kisan2970/ems-haptic-feedback/INTRODUCTION.md

# Introduction: 근육을 액추에이터로 쓰는 햅틱

> 가상 물체에 부딪히면 손목이 저절로 튕기고, 가상 물체를 들면 팔이 아래로 끌린다.
> 모터도 외골격도 없이, 사용자 자신의 근육을 전기로 수축시켜 만든 힘 피드백이다.

이 문서는 저장소를 처음 보는 사람을 위한 입구다. 무엇을 왜 만드는지, 지금 어디까지 왔는지, 어디부터 읽으면 되는지를 담았다.

---

## 1. 문제

VR과 게임은 눈과 귀는 속이지만 **몸은 속이지 못한다.** 가상 벽을 치면 손이 그대로 통과하고, 가상 덤벨은 아무 무게가 없다.

힘을 되돌려 주는 기존 방법은 무겁다.

| 방법 | 한계 |
|---|---|
| 진동 모터 (컨트롤러, 햅틱 조끼) | "윙" 하는 촉감뿐, 팔을 실제로 밀지 못한다 |
| 외골격, 로봇 팔 | 힘은 크지만 모터·배터리 때문에 크고 비싸다 |
| 물리 소품 (passive haptics) | 장면마다 실물을 준비해야 한다 |

## 2. 아이디어

**힘을 내는 모터는 이미 몸 안에 있다.** 근육이다.

피부에 붙인 전극으로 약한 전기 펄스를 보내면(EMS, Electrical Muscle Stimulation) 근육이 의지와 상관없이 수축한다. 이 수축을 가상 세계의 사건에 맞춰 켜고 끄면, 패드 몇 장과 손바닥만 한 회로로 힘 피드백이 생긴다. Pedro Lopes 연구팀의 *Impacto*(UIST 2015)와 *Providing Haptics to Walls & Heavy Objects in VR*(CHI 2017)이 보여준 방향이다.

## 3. 이 프로젝트가 만드는 것

| 시연 | 사용자가 하는 일 | 몸에 일어나는 일 |
|---|---|---|
| **총 반동** | 화면 속 방아쇠를 당긴다 | 손목 신전근이 120ms 수축해 손목이 위로 튕긴다 |
| **벽 충돌** | 손을 뻗어 가상 벽에 닿는다 | 부딪힌 속도에 비례한 길이(60~220ms)로 반동이 온다 |
| **물체 무게** | 가상 물체를 들고 있는다 | 손목 신전근(무거우면 삼두근도)이 계속 수축해 팔이 아래로 끌린다 |
| **공 2개 블라인드 비교** | 똑같은 공 2개를 번갈아 든다 | 한쪽만 자극이 켜진다. 어느 쪽이 무거운지 맞힌 비율을 기록한다 |

무게감의 원리는 단순하다. 손바닥을 위로 하고 팔꿈치를 90도로 들면, 중력은 손등 쪽으로 손을 꺾고 팔꿈치를 펴는 방향으로 당긴다. 같은 방향으로 당기는 근육을 자극하면 사용자는 반대쪽 근육으로 더 버텨야 하고, 그 노력을 **무게**로 느낀다.

## 4. 어떻게 동작하나

```
IMU(손등) ─▶ Arduino Uno ─▶ PC (Processing: 충돌 판정, 자극 길이 계산)
                 ▲                         │
                 └──────── 명령 ◀──────────┘
                 │
                 ▼  빛으로만 연결 (PhotoMOS, 전기적 절연)
 상용 저주파 자극기(TENS 7000, 9V) ─▶ 전극 ─▶ 근육
```

핵심 원칙 세 가지.

1. **자극기는 만들지 않는다.** 전류 크기와 파형은 인증받은 상용 기기가 맡고, 이 시스템은 "언제 흐르게 할지"만 정한다. 기기 내부는 개조하지 않는다.
2. **PC와 몸 사이에 전기 경로가 없다.** 자극기는 배터리로 떠 있고, 제어 신호는 PhotoMOS의 빛으로만 건너간다.
3. **안전장치는 겹겹이, 서로 독립적으로.**

| 계층 | 무엇이 고장 나도 막는가 |
|---|---|
| 기기: 노브 물리 스토퍼, 배터리 구동 | 우리 회로 전체 |
| 참가자 STOP 버튼 (전극 선에 직렬) | 아두이노와 PC |
| 555 하드웨어 감시 (신호가 끊기면 0.05초 안에 차단) | 펌웨어 멈춤 |
| 펌웨어 한도 (반동 250ms, 무게 5초, 1분 누적 30초, 하트비트) | PC 프로그램 |
| 절차 (스크리닝, 동의, 전극은 팔에만) | 사람의 판단 |

## 5. 지금 어디까지 왔나 (2026-11)

- [x] 회로·안전 구조·프로토콜 설계
- [x] TENS 기기 단독으로 근수축 확인 (300µs, 40Hz)
- [x] 브레드보드 조립, 자동 점검 12/12, PhotoMOS 켬 22Ω / 끔 OL
- [x] 펌웨어 v2.1: 안전 한도 버그 수정 / v2.2: 강도 사다리 4단계. PC 시뮬레이션 12/12 (우노·ESP32)
- [x] LED 부하로 TENS 게이팅 동작 확인 (11/9)
- [x] Processing 시연 4종, 공 비교 결과 CSV 기록
- [ ] v2.2 보드 업로드 후 재점검, 강도 사다리 조립·LED 확인
- [ ] 하드웨어 차단 시험, TENS로 팔 무게감 시험
- [ ] 벤치 검사(저항 부하, 안전장치 11종), 본인 캘리브레이션, 발표

남은 핵심 질문은 하나다. **이 자세에서 무게감이 실제로 느껴지는가.** 결과에 따라 다음 단계가 갈린다([SUMMARY.md](SUMMARY.md) 9.2).

## 6. 이 프로젝트의 기여

- **안전을 먼저 설계한 저비용 EMS 햅틱 구조.** 상용 TENS + 광 절연 게이팅 + 하드웨어 감시 + 펌웨어 예산. 부품비 수만 원대로 재현할 수 있다.
- **충돌 물리량을 자극으로 바꾸는 매핑.** 충돌 속도 → 자극 길이, 근육 지연(40~80ms)을 메우는 50ms 예측 트리거.
- **무게감을 블라인드로 검증하는 절차.** 화면 지연을 켜고 끈 두 조건으로 EMS 자체의 효과를 따로 잰다.
- **재현 가능한 기록.** 배선도, 구멍 단위 브레드보드 배치도, 단계별 통과 기준, 하드웨어 없이 돌리는 펌웨어 시뮬레이터.

## 7. 앞으로

| 단계 | 내용 |
|---|---|
| 이번 과목 | 손목 신전근 + 삼두근, 반동과 무게감 시연 |
| 다음 | 이두근·삼각근 추가, 한 팔 슬리브, ESP32 무선 + Unity VR |
| 장기 | 상체 웨어러블. IMU 여러 개로 관절 각도를 재며 근육을 제어하는 폐루프 "몸을 움직이는 옷" |

## 8. 어디부터 읽을까

| 알고 싶은 것 | 문서 |
|---|---|
| 한 장으로 요약 | 이 문서 |
| 왜 이렇게 결정했나 | [BRIEF.md](BRIEF.md) |
| 지금까지 한 일, 검증 기록, 다음 할 일 | [SUMMARY.md](SUMMARY.md) |
| 회로, 프로토콜, 알고리즘 상세 | [README.md](README.md) |
| 직접 따라 만들기 (단계별 통과 기준) | [GUIDE.md](GUIDE.md) |
| 관련 논문 | [references.md](references.md) |

## 안전 고지

전기 근육 자극은 심장박동기·이식 전자기기 사용자, 뇌전증, 심장질환, 임신 중인 사람에게 금기다. 전극은 팔에만 붙인다(가슴·목·머리, 양팔에 걸친 배치 금지). 이 저장소는 교육용 연구 프로토타입 기록이며, 사람에게 연결하기 전에 [GUIDE.md](GUIDE.md)의 벤치 검사를 모두 통과해야 한다.
