kisan2970/ems-haptic-feedback/SUMMARY.md

# 프로젝트 진행 요약 (2026-09-08 ~ 2026-10-28, 10/28 검토 반영)

EMS 근자극 기반 가상 충돌 반동 및 무게감 피드백 시스템. 지금까지 정한 것, 만든 것, 확인한 것, 남은 것을 한 문서에 모았다.

- 설계 상세: [README.md](README.md)
- 단계별 절차: [GUIDE.md](GUIDE.md)
- 외부 공유용 브리핑: [BRIEF.md](BRIEF.md)
- 논문: [references.md](references.md)
- GitHub: https://github.com/kisan2970/ems-haptic-feedback

---

## 1. 목표

**과목**: 대학 인터랙티브 시스템 프로토타이핑 발표·데모.

**시연 두 가지**
1. **총 반동**: 방아쇠를 당기면 손목이 순간적으로 들린다. CH1 손목 신전근을 120ms 자극.
2. **물체 무게**: 똑같이 생긴 공 2개 중 하나를 들면 더 무겁게 느껴진다. 무거운 공을 드는 동안만 손목 신전근(나중에 삼두근 추가)을 계속 자극하고, 화면 속 손도 느리게 따라오게 한다. 블라인드 테스트로 정답률을 기록해 결과 슬라이드에 쓴다.

**사용자 우선순위**: 반동보다 무게감.

**장기 방향**: VR(Unity) 연동, 상체 전반 웨어러블. 이번 과목 범위는 아님.

---

## 2. 핵심 결정과 근거

### 2.1 자극원: 상용 TENS 기기, 출력단 무개조
- 자극 파형과 전류 제한은 인증받은 상용 기기에 맡기고, 우리 회로는 "언제 흐르게 할지"만 정한다. 잘못 동작했을 때의 위험 증명 책임이 기기 쪽에 남는다.
- 직접 만든 자극기는 펌웨어 버그 하나로 직류가 흘러 화상이 날 수 있고, 다른 사람에게 적용할 근거가 약하다. 8채널 이상 웨어러블 단계에서나 검토.
- Lopes 연구실의 openEMSstim도 같은 철학이다.

### 2.2 기기 선택: TENS 7000 계열 (아날로그 노브, 9V)
- "TENS라서 근수축이 안 된다"는 주장(외부 AI의 첫 판단)을 파라미터로 검토해 틀렸다고 결론. 이후 그 AI도 판단을 수정했다.

| 파라미터 | 근수축에 필요 | 산 기기 | 판정 |
|---|---|---|---|
| 펄스 폭 | 200~300µs | **300µs** (실측 확인) | 충분 |
| 주파수 | 30~50Hz | 2~150Hz | 충분 |
| 전류 | 전완 15~30mA | 최대 100mA @500Ω | 충분 |
| 파형 | 양극성 | 비대칭 양극성 구형파 | 동급 |
| 연속 출력 | 필요 | Normal + 타이머 C | 있음 |
| 강도 상한 고정 | 물리 스토퍼 | 아날로그 노브 | 가능 |

- 산 것: 알리 동형품(박스 표기 R-C1011), 배터리 듀얼 채널 버전. 4채널 충전식은 버튼형·프로그램 강제·패드 감지 때문에 제외.
- 약점: 정전류가 아니어서 건조한 피부에서 전류가 줄어든다. 피부 준비와 패드 크기로 보완.

### 2.3 제어 방식: 출력선 게이팅
- 기기는 고정 강도로 켜 두고, 전극으로 가는 선 한 가닥에 **PhotoMOS(AQY210EH)**를 넣어 1ms 단위로 개폐한다.
- 일반 포토커플러(PC817)는 35V 단방향이라 양극성 고전압 펄스를 못 통과시켜 제외.
- 버튼을 대신 눌러 주는 방식은 램프업 때문에 짧은 반동이 불가능해 제외.
- 실측: PhotoMOS가 켜졌을 때 22Ω. 피부 저항 500~2,000Ω 대비 손실 1~4%.

### 2.4 이 보드로 할 수 있는 것과 없는 것
- 가능: 켜고 끄는 시점, 지속 시간(반동 10~250ms, 무게 최대 5초), 채널 선택.
- 세기(강약): 기본은 TENS 노브가 정한다. 펌웨어의 듀티 값은 출력을 끊어 떨림을 만들 뿐 약해지지 않는다.
- **11/9 강도 사다리 추가 (v2.2)**: 출력 경로에 470Ω·1kΩ을 직렬로 넣고 PhotoMOS 2개로 각각 건너뛰어 4단계(`$L,ch,0~3`). 노브 세기보다 세질 수 없고, 리셋되면 가장 약한 단계가 된다. 상세는 README 1.4b.

### 2.5 무게감 원리
- 손바닥을 위로 하고 팔꿈치를 90도로 한 자세에서, 중력은 손을 손등 쪽으로 꺾고 팔꿈치를 펴는 방향으로 당긴다.
- 손목 신전근(손을 손등 쪽으로 젖힘)과 삼두근(팔꿈치를 폄)은 **중력과 같은 방향**으로 당긴다. 사용자는 반대쪽 근육으로 더 버티게 되고, 그 노력을 무게로 느낀다. Lopes 외 CHI 2017과 같은 원리.
- **자세가 틀리면 무게감이 아니다.** 손바닥을 아래로 해서 움켜쥐면 오히려 손이 들린다.
- 예상 크기: 손목만 1.5~3kg 상당, 삼두근을 더하면 더 큼. 2~3초 지나면 근피로로 약해짐.
- 손바닥 압력은 EMS로 못 만들므로 진짜 공을 쥐게 한다. 화면 속 손 지연이 "당김"을 "무게"로 해석하게 돕는다.

### 2.6 떨림 줄이기
- 75Hz에서 마사지기 같은 떨림이 느껴졌다. 완전히 없앨 수는 없다(피부 감각신경이 먼저 반응).
- **40Hz, 300µs, 강도는 운동 역치(M)보다 약간 위**로 설정. Normal 모드 외(Burst, Modulation 등)는 쓰지 않는다.
- 실제 시연은 짧게 켜져서 떨림이 덜 느껴진다.

### 2.7 MCU: 아두이노 우노
- ESP32도 있으나, 이번 과목은 5V 회로 여유와 안정성 때문에 **우노**로 확정. 포트는 COM11(CH340). COM3~6은 블루투스 포트.
- ESP32 펌웨어는 VR 단계용으로 유지.

---

## 3. 안전 구조

| 계층 | 수단 | 무엇이 고장 나도 동작하나 |
|---|---|---|
| 기기 | 출력단 무개조, 노브 물리 스토퍼, 9V 배터리 플로팅 | 우리 회로 전체 |
| 하드웨어 차단 | 참가자 STOP(NC) 전극 경로 직렬, PhotoMOS 무전원 시 열림, 게이트 핀 10k 풀다운 | 아두이노, PC |
| 하드웨어 감시 | 555 "펄스 끊김 감지": 아두이노가 D9를 계속 토글할 때만 켜짐. 멈추면 약 0.05초 안에 차단 | 펌웨어 멈춤, 핀 고착 |
| 펌웨어 | 반동 최대 250ms·간격 300ms, 무게 최대 5초+휴식 2초, 1분 예산, 하트비트 1초, 워치독 250ms, 비상정지 인터럽트 | PC 프로그램 |
| 절차 | 스크리닝(심박조율기, 뇌전증, 심장질환, 임신, 피부 상처), 동의, 전극은 팔에만, 본인 선시연 | 사람 판단 |

**간소화판(현재 조립본)**: 키스위치·부저·실험자 비상정지를 뺐다. 대신 실험자는 노트북 SPACE 키(전부 정지)를 맡고, 참가자 STOP과 하드웨어 감시는 그대로.

**절연 원칙**: TENS 쪽 선(주황)은 아두이노 GND·핀에 절대 닿지 않는다. 브레드보드 20·21열(CH2는 50·51열) 위쪽 a~e는 TENS 전용.

---

## 4. 회로 (CH1 기준, 우노)

| 블록 | 연결 |
|---|---|
| TLC555 (DIP-8) | 8·4번 → 5V, 1번 → GND, 5번 → 10nF → GND |
| 타이밍 | 6·7번 연결 → **470kΩ** → 5V, 같은 점 → **100nF(104)** → GND (약 0.05초) |
| 트리거 | D4 → 10nF → 555 2번, 2번 → 10kΩ → 5V |
| 유지 신호 (Q3) | D9 → 100nF → 1kΩ → Q3 베이스, 베이스 → 10kΩ → GND, 컬렉터 → 555 6·7번 |
| 출력 | 555 3번 → 330Ω → PhotoMOS 1번 |
| 게이트 (Q1) | D5 → 1kΩ → Q1 베이스, D5 → 10kΩ → GND, 컬렉터 → PhotoMOS 2번 |
| PhotoMOS (DIP-4) | 1번 LED+, 2번 LED−, **3·4번 출력** |
| TENS 쪽 | TENS 리드 A → PhotoMOS 3번(a21), 4번(a20) → 참가자 STOP 11번 → 12번 → 패드 A. 리드 B → 패드 B |
| 패널 (간소화판) | D3 → GND 직결(상시 아밍 허용), D2·D8 비움 |
| IMU | 3.3V → VCC, GND, A4 → SDA, A5 → SCL |

CH2: 트리거 D7, 게이트 D6, 유지 신호 D10, 같은 회로를 30열 오른쪽에.

**바뀐 부품 값과 이유**
- 555 타이밍: 처음 270kΩ×1µF(0.3초 고정 창) → 무게감을 위해 펄스 끊김 감지 방식으로 바꾸며 100kΩ×1µF → 1µF가 없어 1MΩ×100nF → 1MΩ이 없다고 해서 500kΩ → 최종 **470kΩ×100nF**. 1MΩ이 있는 것으로 확인돼 1MΩ은 벤치 측정용 피크 검출기에 쓴다.
- PhotoMOS 출력 핀: 처음 문서에 4·6번으로 잘못 적었다가 **3·4번**으로 정정.

**참가자 STOP 단자 읽는 법**: 11·12 = NC(평소 연결), 23·24 = NO(평소 끊김). 출력 차단에는 11·12만 쓴다. 2채널을 한 버튼으로 끊으려면 NC 접점 블록 추가 필요.

---

## 5. 소프트웨어

### 5.1 펌웨어 v2 (`firmware/ems_recoil/ems_recoil.ino`)
- 상태머신, `delay()` 없는 논블로킹 구조, 센서 100Hz.
- 반동 `$T,채널,ms,듀티,봉투`, 무게 `$W,마스크`(100ms마다 재전송해야 유지).
- **v2.1 안전 예산 수정 (10/28)**: 12장 참고. 분당 반동 제한, 무게 누적 계산, 정지 경로의 누적 누락, 재들기 간격 0.5초, I2C 타임아웃.
- **버그 수정 (10/7)**: 루프 맨 앞에서 현재 시각을 읽고 그 뒤에 명령을 처리해서, 명령이 기록한 시각이 더 커지면 부호 없는 뺄셈이 뒤집혔다. 증상은 반동이 바로 끝남, 무게 유지가 바로 풀림, 하트비트 끊김 오판. 명령 처리 뒤에 시각을 읽도록 수정. ESP32 펌웨어도 같이 수정.
- **ESP32 (10/28)**: v1 구조에 머물러 v2 회로(유지 신호 필요)에서 자극이 나가지 않던 것을 우노 v2.1과 같은 로직으로 이식. 유지 신호는 GPIO32(CH1)·GPIO33(CH2).

### 5.2 프로토콜
`$본문*체크섬` (XOR), 115200bps.

```
$H*48            하트비트
$A,1*5C          아밍
$X*58            전부 정지
$R*52            FAULT 해제
$T,1,120,100,0*57   총 반동 (CH1 120ms)
$W,1*4A          무게 (CH1)       $W,3*48  CH1+CH2       $W,0*4B  해제
```

### 5.3 Processing 시연 화면 (`processing/EMSRecoilSim/EMSRecoilSim.pde`)

| 모드 | 내용 |
|---|---|
| 1 총 | 클릭 또는 F로 발사, 120ms 반동, 화면 반동 연출 |
| 2 들기 | P로 들기, Z/X/C로 가벼움/보통/무거움, 무거울수록 화면 속 손이 늦게 따라옴 |
| 3 벽 | IMU로 손을 뻗어 벽에 닿으면 속도에 비례한 반동 |
| 4 공 비교 | 똑같은 공 2개 중 하나만 무거움. H 섞기, J/K 참가자 답, V 정답, L 화면 지연 켜기/끄기. `ball_results_v2.csv`에 기록 (`visual_lag` 열 포함) |

공통 키: A 아밍, SPACE 정지, R 해제, T 테스트. 공 비교의 `HEAVY_MASK`는 지금 1(CH1), CH2를 붙이면 3.

Processing 4.5 설치 완료, 스케치 컴파일 통과. 실제 화면 실행은 아직.

### 5.4 도구 (`tools/`)

| 파일 | 용도 |
|---|---|
| `board_check.py` | 펌웨어·배선 자동 점검 12항목 |
| `ssr_blink.py` | PhotoMOS를 2초 켜고 2초 끄기 반복 (멀티미터 확인용) |
| `serial_test.py` | 간단한 시리얼 응답 점검 |
| `firmware_sim/` | 하드웨어 없이 PC에서 펌웨어 안전 예산·강도 사다리 12항목 시뮬레이션 (g++) |
| `duty_test.py` | 듀티 100/70/50/30%·감쇠 반동을 차례로 (LED 부하) |
| `ladder_test.py` | 강도 단계 3 → 0을 2초씩 (LED 부하) |
| `make_wiring.py`, `make_breadboard.py`, `make_probe_guide.py`, `make_pad_guide.py` | 그림 생성 스크립트 |

---

## 6. 만든 그림 (`docs/`)

| 파일 | 내용 |
|---|---|
| `wiring_ch1_uno.png` | CH1 회로 배선도 v2 |
| `breadboard_830.png` / `BREADBOARD.md` | 830홀 브레드보드 실물 배치도와 구멍별 목록 (전체판) |
| `breadboard_830_simple.png` / `BREADBOARD_simple.md` | 간소화판 (현재 조립본) |
| `probe_a20_a21.png` | 멀티미터로 PhotoMOS 확인하는 법 |
| `pad_placement.png` | 패드 붙이는 위치 (CH1 손목 신전근, CH2 삼두근) |

코덱스(ChatGPT 앱)로 해부학 그림도 생성했다. 2채널 그림에서 패드 위치는 대체로 맞았지만 패드 크기가 작게 그려졌고, 뒤에서 본 그림에 "elbow crease"가 잘못 표시됐다. 위치 참고용으로만 쓴다.

**패드 위치 요약 (CH1)**: 팔꿈치 바깥 뼈(외측상과)에서 검지·중지 손등 뿌리 쪽으로 잇는 선 위. 패드 A 중심은 뼈에서 5cm, 패드 B 중심은 그보다 8cm 더 손목 쪽. 주먹을 쥐고 손등을 젖히면 볼록해지는 곳. 손가락만 펴지면 엄지 쪽으로 1cm.

---

## 7. 부품 현황

### 7.1 보유
TENS 7000 동형품, 아두이노 우노 호환(USB-C, CH340), ESP32 DevKit V1 + 확장보드, GY-521, AQY210EH DIP-4 ×10, TLC555CP DIP-8 ×5, 2N3904, 1N4148, 저항 키트(470kΩ, 1MΩ 포함, 270kΩ 없음), 세라믹 커패시터 키트(1µF 없음), 만능기판 7×9, KF301 단자대, 핀헤더, 비상정지(1NC+1NO), 참가자 버튼, 키스위치, 부저, 4×6cm 하이드로겔 패드(동봉 4장 + 리필), 브레드보드, 점퍼선, 멀티미터(수동 레인지).

### 7.2 아직 필요하거나 확인할 것
| 품목 | 상태 |
|---|---|
| 예비 리드선 (기기 쪽 2.35mm DC 플러그 → 2.0mm 핀) | 쿠팡 검색어 "TENS 7000 리드선", "저주파 리드선 2.35" |
| 삼두근용 5×10cm 패드 | CH2 단계에서 |
| NC 접점 블록 또는 2NC 버튼 | CH2를 참가자 STOP 하나로 끊을 때 |
| 인두 세트 | 만능기판 납땜을 할 때 |
| 9V 건전지 여분, 알코올 솜 | 시연 전 |

**패드 운영**: 비용 때문에 하이드로겔 패드 1~2세트를 물로 재생해 쓰기로 함. 마르거나 들뜬 패드는 쓰지 않는다. 전도 젤은 하이드로겔에 덧바르지 않는다.

---

## 8. 검증 기록

| 날짜 | 항목 | 결과 |
|---|---|---|
| 9/28 | v1 펌웨어 업로드, 시리얼 응답 | 정상 |
| 9/29 | TENS 기기 단독 (300µs, 9V) | 동작 확인. 75Hz에서 떨림 → 40Hz로 변경 |
| 10/7 | v2 업로드, 자동 점검 | 버그 발견·수정 후 11/12 통과 (IMU 미연결) |
| 10/7 | IMU 연결 후 자동 점검 | **12/12 통과**, 가속도 0.94g |
| 10/8 | CH1 PhotoMOS 멀티미터 시험 | **켬 22Ω, 끔 OL**. 부저는 기준 저항이 낮아 안 울림 |
| 10/28 | 펌웨어 PC 시뮬레이션 (`tools/firmware_sim`) | 수정 전 9항목 중 5개 실패 → v2.1 우노·ESP32 모두 9/9 통과. **보드 재업로드와 `board_check.py` 재실행은 아직** |

---

## 9. 다음 단계

### 9.0 11/9 진행
- `ssr_blink.py`(COM17)로 LED 부하 게이팅 확인: 아밍 전 꺼짐, 명령 시 켜짐. **통과**.
- 강도 사다리(v2.2) 설계·배치·펌웨어 완료, PC 시뮬레이션 12/12. **보드 조립과 `ladder_test.py` 확인은 아직**.
- 우노 포트가 COM11 → **COM17**로 바뀜. Processing `PORT_NAME`과 스크립트 인자를 COM17로.

### 9.1 오늘 할 일 (CH1)
0. **펌웨어 v2.1 업로드 후 `board_check.py COM11` 다시 실행** (12/12 나와야 함. 부팅 메시지가 v2.1인지 확인)
1. **하드웨어 안전 차단 시험**: D9를 a3에서 뽑고 `ssr_blink.py COM11 1` 실행, 멀티미터가 계속 OL이면 통과. 실패하면 사람 연결 금지.
2. **TENS 기기만으로 팔 시험**: 동봉 리드선, Normal/300µs/40Hz, 손바닥 위·팔꿈치 90도로 공을 쥐고 S(감각)·M(운동)·C(편안 최대) 기록. 켰을 때 공이 무거워지는지 확인.
3. **예비 리드선 연결**: 빨강 선을 잘라 기기 쪽은 a21, 패드 쪽은 참가자 STOP 12번.
4. **벤치 비교**: 1kΩ 부하에서 직접 연결 대비 보드 경유 값이 5% 안쪽이면 통과.

### 9.2 결과에 따른 결정
| 2번 결과 | 다음 |
|---|---|
| 확실히 무거워짐 | 회로 확정, 출력부(PhotoMOS + 단자대) 만능기판 납땜 |
| 약함 | 출력부만 납땜, CH2(삼두근) 추가 시험 |
| 찌릿하기만 함 | 납땜 보류, 패드 위치부터 조정 |

### 9.3 이후
본인 캘리브레이션 → Processing 화면 실제 실행 → 공 비교 리허설(참가자당 5~10회) → 발표 자료(정답률, 반동 영상, 안전 구조) → 필요하면 CH2.

---

## 10. GitHub 반영 상태
- 10/28: 펌웨어 v2.1(우노·ESP32), 펌웨어 시뮬레이터, 공 비교 화면 지연 토글, 문서 정리, 이 요약의 12장.
- 올라간 것: 초기 공개(9/29), 브레드보드 배치도와 470kΩ 변경(10/6).
- **아직 안 올라간 것**: 펌웨어 시간 버그 수정, ESP32 동일 수정, Processing 공 비교 모드, GUIDE 키 안내, 자동 점검·PhotoMOS 시험 스크립트, 멀티미터 안내 그림, 패드 위치 그림, 이 요약 문서.

---

## 11. 대화 중 나온 질문과 답 (요점)

| 질문 | 답 |
|---|---|
| TENS로 근수축이 되나 | 된다. 라벨이 아니라 펄스 폭·주파수·전류가 기준이고 모두 충분 |
| 3kg 무게감이 가능한가 | 손목만으로는 어렵다(근력의 25~50% 필요). 삼두근을 더하면 현실적. 목표는 "지각된 무게" |
| 직접 자극기를 만들면 안 되나 | 가능하지만 위험 증명이 어렵다. 제어·안전 회로 설계로 충분한 기여 |
| 4채널 기기는 | 버튼형이라 맞지 않음. 2채널 기기 + 릴레이 다중화로 4근육 가능 |
| 4근육 동시 자극하면 | 길항근끼리 상쇄해 관절이 잠긴다. 무게감이 아니라 "굳는" 느낌 |
| 진동 느낌은 | 저주파(5~15Hz)나 짧게 끊는 패턴으로 가능. 반대로 떨림을 줄이려면 40Hz 이하 |
| 브레드보드를 지나도 TENS 신호가 정상인가 | 정상. PhotoMOS는 양방향·350V·22Ω이라 손실 1~4% |
| 세기 조절이 되나 | v2.2부터 강도 사다리 4단계(`$L`). 노브가 상한, 사다리는 낮추기만 |
| 공 2개 무게 차이 | CH1만으로 "자극 없음 대 자극 있음"으로 가능. 자세는 손바닥 위 |
| 만능기판은 언제 | 팔 시험 후. 출력부는 먼저 납땜해도 됨 |

---

## 12. 10/28 검토와 수정

저장소 전체를 다시 읽고 찾은 문제와 처리 결과.

### 12.1 고친 것
| 문제 | 위험 | 처리 |
|---|---|---|
| 분당 반동 제한(40)이 기록 버퍼(32)보다 커서 한 번도 걸리지 않음 | 시뮬레이션에서 1분에 170회 반동 | 버퍼를 제한 + 8로 |
| 무게 누적이 최근 8회만 셈 | 1초씩 짧게 반복해 들면 1분 30초 한도를 넘김 | 10초 칸 6개에 시간으로 누적 |
| `$X`·하트비트 끊김·ARM OFF·비상정지로 끊긴 무게가 누적에 안 들어감 | 들기 → `$X` → 재아밍 반복으로 184초 중 158초 자극 | `allOff()`가 `holdStop()`을 거쳐 기록 (수정 후 94초) |
| 내려놓고 바로 다시 들면 휴식 없이 이어짐 | 4.9초씩 끊어 거의 연속 자극 | 재들기 최소 간격 0.5초 |
| 우노 I2C에 타임아웃 없음 | EMS 노이즈로 버스가 잠기면 워치독 리셋 반복 | `setWireTimeout(3ms)`, 실패 샘플 건너뜀 |
| ESP32 펌웨어가 v1 (유지 신호 없음, `$W` 없음) | v2 회로에 꽂으면 0.05초 만에 꺼짐 | 우노 v2.1 로직으로 이식, KA = GPIO32/33 |
| 공 비교에서 무거운 공만 화면 속 손이 느림 | 참가자가 화면만 보고 맞힐 수 있어 EMS 효과가 섞임 | L 키로 화면 지연 끄기, CSV `visual_lag` 열 |
| README 프로토콜 표 (state 3, 오류 11~14 누락), 더미 로드 D9 충돌, 재질 키 미구현 | 문서와 코드 불일치 | 정정 |

### 12.2 남은 위험 (하드웨어로만 확인 가능)
- **v2의 555는 "멈춤"만 잡는다.** v1의 0.3초 절대 상한과 달리, 펌웨어가 정상적으로 돌면서 잘못 켜 둔 경우(논리 버그)는 못 막는다. 무게 5초 제한은 소프트웨어에만 있다. 상체 확장 전에 약 6초 절대 상한 타이머를 하드웨어에 하나 더 두는 것을 검토.
- **펄스 중간 절단.** PhotoMOS가 TENS 펄스와 상관없이 개폐되어 반쪽 펄스가 생길 수 있다(직류 성분). GUIDE 6.1-5에 오실로스코프 확인 항목 추가. 듀티 변조(듀티 < 100)는 개폐가 많아 더 불리하다.
- **총 모드 화면 연출**은 펌웨어가 거부(`TOO_SOON`, `NOT_ARMED`)해도 나온다. 평가에 쓸 때는 ACK 기준으로 기록.

### 12.3 장기 목표(상체 웨어러블, VR, 제품화)와의 간격
- IMU가 손등 하나뿐이라 팔꿈치 각도를 모른다. "몸을 움직이게" 하려면 전완·상완 IMU 2개 이상과 폐루프 제어(목표 각도 도달 시 자극 중단)가 필요하다.
- ESP32는 아직 USB 시리얼만 쓴다. Quest 단독 VR은 BLE 또는 Wi-Fi가 필요하다. Unity 연동 코드는 없다.
- 상용 TENS 게이팅 구조는 연구·데모용이다. 제품은 자체 구동 회로와 인증(KC, 의료기기 해당 여부)이 필요하다.
- 공개 저장소에 올린 설계는 나중에 특허 신규성을 잃는다. 사업화를 생각하면 공개 범위와 LICENSE를 정한다 (현재 LICENSE 없음).
