kisan2970/ems-haptic-feedback/BRIEF.md

# EMS 반동 시뮬레이터 프로젝트 브리핑

관심 있는 분께 공유하는 요약본입니다. "무엇을, 왜, 어떻게" 결정했는지와 직접 해 보려면 뭐가 필요한지를 정리했습니다.
상세 설계는 README.md, 제작 절차는 GUIDE.md, 논문 목록은 references.md에 있습니다.

---

## 1. 프로젝트가 뭔가

화면(나중엔 VR) 속 벽에 손이 부딪히는 순간, 전완의 손목 신전근에 붙인 저주파 자극기(EMS)가 60~250ms 동안 켜져서 손목이 **저절로** 뒤로 젖혀집니다. 사용자의 근육이 액추에이터가 되므로 외골격이나 모터 없이 힘 피드백이 생깁니다. 물건을 들 때는 삼두근을 자극해 "팔이 펴지려는 저항"으로 무게감을 만듭니다.

원조 연구는 Pedro Lopes(시카고대, 전 HPI)의 Impacto(UIST 2015)와 Providing Haptics to Walls & Heavy Objects in VR(CHI 2017)입니다. 이 분야 이름은 EMS haptics, muscle-propelled force feedback, human-computer integration입니다.

```
IMU(손등) → 아두이노 → 시리얼 → Processing(충돌 판정, 매핑) → 아두이노 → 게이팅 보드(PhotoMOS) → 저주파 자극기 출력 → 전극 → 근육
```

---

## 2. 핵심 설계 결정과 이유

### 2.1 자극기를 직접 만들지 않고 상용 TENS를 쓴다
- 상용 인증 기기의 출력단(승압, 전류 제한, 파형 안전)은 손대지 않고, 우리 회로는 "언제 전류를 통과시킬지"만 결정합니다. 잘못 동작했을 때의 위험 증명 책임이 기기 제조사 쪽에 남습니다.
- Lopes 연구실의 openEMSstim(오픈 하드웨어)도 같은 철학입니다. 상용 EMS/TENS 출력을 받아 감쇠·개폐만 합니다.
- 자작 자극기는 H-브리지 버그 하나로 DC가 흘러 전기분해 화상을 낼 수 있고, 타인에게 적용할 근거를 만들기 어렵습니다. 8채널 이상 필요해지는 웨어러블 단계에서나 검토합니다.

### 2.2 "TENS라서 근수축이 안 된다"는 틀렸다
소비자용 TENS와 EMS는 대개 같은 출력단에 프로그램만 다릅니다. 근수축에 필요한 건 라벨이 아니라 아래 파라미터입니다.

| 파라미터 | 필요 범위 | TENS 7000 계열 | 판정 |
|---|---|---|---|
| 펄스 폭 | 200~300µs (운동신경 크로낙시 100~300µs) | 30~260 또는 50~300µs 조절 | 충분. 큰 근육에서는 300µs 이상이 10~20% 더 편함 |
| 주파수 | 30~50Hz (강직성 융합) | 2~150Hz 조절 | 충분 |
| 전류 | 전완 운동역치 15~30mA | 0~100mA @500Ω | 충분 |
| 파형 | 양극성, 순전하 0 | 비대칭 양극성 구형파 | 동급 |
| 연속 출력 | 외부 게이팅용 "가만히 켜진 출력" | Normal 모드 + 타이머 C | 소비자용 EMS는 램프업·수축/이완 사이클이 강제라 오히려 불리 |
| 강도 상한 고정 | 물리 스토퍼 | 아날로그 노브 | 버튼형은 불가 |

진짜 약점은 정전류가 아니라는 것(건조 피부에서 전류 감소)과 펄스 폭 상한입니다. 연구용 정전류 자극기(Hasomed RehaMove)는 이걸 해결하지만 300만 원 이상입니다.

### 2.3 출력 라인 게이팅 (버튼 흉내가 아니라)
- 기기 버튼을 옵토커플러로 눌러 주는 방식은 램프업 때문에 50~200ms 임펄스가 불가능합니다.
- 대신 기기를 고정 강도로 켜 두고, 전극 리드 한 가닥에 PhotoMOS(AQY210EH, 350V, 1.5kV 절연)를 직렬로 넣어 1ms 단위로 개폐합니다.
- 일반 옵토커플러(PC817)는 35V 단방향이라 ±100V 양극성 펄스를 못 막습니다. PhotoMOS나 리드릴레이여야 합니다.

### 2.4 안전은 5겹, 서로 독립
| 계층 | 수단 |
|---|---|
| 기기 고유 | 인증 기기 무개조, 노브 물리 스토퍼, 9V 배터리(PC 접지와 분리) |
| 하드웨어 차단 | 전극 경로에 실험자 비상정지 NC + 참가자 정지 NC 직렬. PhotoMOS는 무전원 시 열림. 게이트 핀 풀다운 |
| 하드웨어 시간 제한 | 555 모노스테이블이 0.33초 창을 열고 AND 게이트. 펌웨어가 죽어도 0.33초 뒤 차단 |
| 펌웨어 | 1회 최대 250ms, 휴지 300ms, 10초당 듀티 30%, 분당 30회, PC 하트비트 1초 타임아웃, 워치독, 아밍 키스위치, FAULT 래치 |
| 절차 | 스크리닝(심박조율기, 뇌전증, 심장질환, 임신, 피부손상), 동의, 전극은 팔에만, 본인 선시연, 참가자당 40회 |

### 2.5 무게감은 어디서 나오나
- EMS는 외력을 가하는 게 아니라 근육을 수축시키므로, 힘의 상한은 "참을 수 있는 자극에서의 근력"(표면 EMS로 대개 MVC의 20~30%)입니다.
- 손목만으로 3kg 상당은 어떤 기기로도 어렵고(손목 신전 MVC의 25~50%), 팔꿈치 삼두근을 길항근으로 자극하면 3kg 상당(MVC의 15~18%)이 현실적입니다. 시각적 클램핑과 합치면 지각된 무게는 1.5배 정도 커집니다.
- 예상 체감: 손목 1.5~3kg(손바닥에 생수병), 삼두근 2~4kg(아령 들어올리는 저항), 어깨 1~1.7kg.

### 2.6 지연
IMU 10ms + 시리얼 8ms + 판정 1ms + PhotoMOS 1ms + **근육 전기-기계 지연 40~80ms** ≈ 50~100ms. 근육이 지배적이라 소프트웨어에서 충돌을 50ms 먼저 예측해 쏩니다(Kasahara & Lopes, Preemptive Action, CHI 2019).

---

## 3. 부품과 비용 (알리 기준 약 10~13만 원)

| 부품 | 역할 | 대략 가격 |
|---|---|---|
| TENS 7000 계열 (9V, 듀얼 채널, 아날로그 노브) | 자극원 | 5~6만 원 (국내 16만) |
| 아두이노 우노 R3 호환 | 센서 + 게이트 제어 | 1만 |
| ESP32 DevKit V1 | VR 단계 무선용 | 1만 |
| GY-521 MPU-6050 | 손 기울기·속도 | 3천 |
| AQY210EH PhotoMOS DIP-4 ×10 | 절연 스위치 | 4천 |
| TLC555CP DIP-8 ×5 | 하드웨어 시간 창 | 2천 |
| 2N3904, 1N4148, 저항·커패시터 키트 | 드라이버, 타이밍 | 8천 |
| 만능기판 7×9 양면, KF301 단자대, 핀헤더 | 보드 | 5천 |
| E-STOP(1NC+1NO), NC 버튼, 키스위치, 부저 | 안전 인터록 | 1만 |
| 하이드로겔 패드 5×5 / 5×9, 리드선 2.5mm→2.0mm 핀 | 전극 (소모품, 쿠팡) | 2만 |

주의: 4채널 충전식 TENS는 버튼형이라 스토퍼 불가·프로그램 강제·패드 감지가 있어 이 구조에 안 맞습니다. 2채널 기기 + DPDT 릴레이 다중화로 한 팔 4근육이 됩니다.

---

## 4. 소프트웨어 구조

- **프로토콜**: `$본문*체크섬` 텍스트 라인, 115200. 센서는 100Hz로 `$S,seq,roll,pitch,gx,gy,gz,ax,ay,az,dist,state`, 트리거는 `$T,채널,지속ms,듀티%,봉투`. 하트비트 `$H` 200ms마다, 끊기면 자동 해제.
- **매핑**: 충돌 속도 v → 지속시간 T = 60 + 160·(v/v_max)^0.7 ms. 재질(강철/고무/폼)에 따라 듀티와 감쇠 봉투. 벽 관통 깊이로 듀티 가산. 불응기 300ms, 히스테리시스로 채터링 방지.
- **펌웨어**: 상태머신 IDLE→ARMED→STIM→COOLDOWN, 어디서든 FAULT. `delay()` 없이 `millis()` 기반. 비상정지는 인터럽트.
- **호스트**: 지금은 Processing, VR 단계는 Unity(시리얼 또는 UDP). Grasshopper+Firefly도 가능하지만 솔브 속도 때문에 시각화만 맡기는 편이 낫습니다.

---

## 5. 자주 나오는 질문

**Q. 직접 만들면 안 되나?** 만들 수는 있지만 출력단 안전(전류 상한, DC 차단, 단일 고장)을 본인이 증명해야 하고 타인에게 적용할 근거가 약해집니다. 제어·안전 회로를 직접 설계하는 것만으로도 기술적 기여는 충분합니다.

**Q. 네 근육을 동시에 켜면?** 길항근이 서로 상쇄해 관절이 잠깁니다. 무게감 4배가 아니라 "굳는" 효과이고, 벽에 박힌 느낌 같은 특수 효과로만 짧게 씁니다.

**Q. 원할 때마다 근수축을 코딩으로?** 됩니다. 기기 자체가 아니라 출력 선의 스위치 보드를 코딩하는 것이고, 타이밍·지속·패턴은 소프트웨어, 절대 강도·펄스 폭은 기기 노브·버튼입니다.

**Q. 개인차는?** 감각 역치 S → 운동 역치 M → 편안 최대 C를 5분 안에 재서 운용 강도 = M + 0.3(C−M)로 잡습니다. 피부 준비(스왑, 젤)와 패드 크기가 사실상 강도 설정의 일부입니다.

---

## 6. 직접 해 보려면

1. GUIDE.md 순서대로. 핵심은 **사람 연결은 저항 부하 벤치 테스트와 안전장치 8종 검사를 통과한 뒤**라는 것.
2. 코드는 `firmware/ems_recoil/ems_recoil.ino`(우노)와 `processing/EMSRecoilSim/EMSRecoilSim.pde`. 둘 다 그대로 돌아갑니다.
3. 읽을 것: Impacto 논문(https://plopes.org/wp-content/uploads/papers/2015-UIST-Impacto.pdf), openEMSstim 튜토리얼(https://github.com/PedroLopes/openEMSstim), 2025년 EMS 햅틱 서베이(https://arxiv.org/abs/2504.21477).
