kisan2970/ems-haptic-feedback/docs/BREADBOARD.md

# 브레드보드 꽂는 위치 목록 (830홀, 우노, 2채널 v2)

그림: [breadboard_830.png](breadboard_830.png). 열 번호 1~63, 행 a~j. 위쪽 레일은 바깥쪽 빨강 줄이 +5V, 안쪽 파랑 줄이 GND. 아래쪽은 안쪽 파랑이 GND, 바깥쪽 빨강이 +5V.

레일 구멍은 5개씩 묶여 있고 7·13·19·25·31·37·43·49·55·61열 자리는 비어 있다.

## 공통

| 부품 | 위치 |
|---|---|
| 점퍼선 (위 + 레일 ↔ 아래 + 레일) | 위 + 레일 60열 ↔ 아래 + 레일 60열 |
| 점퍼선 (위 − 레일 ↔ 아래 − 레일) | 위 − 레일 59열 ↔ 아래 − 레일 59열 |
| IMU (GY-521) | 우노 3.3V → VCC, 우노 GND → GND, A5 → SCL, A4 → SDA. 시연 때는 긴 선으로 손등에 고정 |
| 전원 | 우노 5V → 위 + 레일 2열, 우노 GND → 위 − 레일 4열 |
| 우노 신호선 | D9 → a3, D4 → j8, D5 → g28, D11 → j14, D12 → j22 (CH1) / D10 → e33, D7 → j38, D6 → g58, A0 → j44, A1 → j52 (CH2) |
| 키스위치 | D3 → 키스위치 → 아래 − 레일 32열 |
| 부저 | D8 → 부저 + , 부저 − → 아래 − 레일 33열 |
| 실험자 E-STOP | NC1: a26 ↔ 참가자 NC1 (CH1), NC2: a56 ↔ 참가자 NC2 (CH2), NO: 우노 D2 ↔ 위 − 레일 57열 |
| 참가자 STOP | NC1: E-STOP NC1 ↔ CH1 패드 A, NC2: E-STOP NC2 ↔ CH2 패드 A |

## CH1 (손목 신전근: 트리거 D4, 게이트 D5, 유지 D9)

| 부품 | 위치 |
|---|---|
| 유지 신호 선 도착점 | a3 |
| 커패시터 100nF (104) | c3 ↔ c5 |
| 저항 1kΩ | b5 ↔ b8 |
| 저항 10kΩ | a8 ↔ 위 − 레일 9열 |
| 트랜지스터 Q3 2N3904 | E=e7, B=e8, C=e9 (평평한 면이 가운데 홈 쪽) |
| 점퍼선 (Q3 이미터 → GND) | a7 ↔ 위 − 레일 6열 |
| 점퍼선 (Q3 컬렉터 → 555 7번) | d9 ↔ d11 |
| TLC555 (홈이 왼쪽) | 1번=f10, 2번=f11, 3번=f12, 4번=f13 / 8번=e10, 7번=e11, 6번=e12, 5번=e13 |
| 점퍼선 (555 8번 → 5V) | a10 ↔ 위 + 레일 10열 |
| 점퍼선 (555 7번 ↔ 6번) | b11 ↔ b12 |
| 저항 470kΩ | a11 ↔ 위 + 레일 11열 |
| 커패시터 100nF (104) | a12 ↔ 위 − 레일 12열 |
| 커패시터 10nF (103) | a13 ↔ 위 − 레일 14열 |
| 트리거 선 도착점 | j8 |
| 커패시터 10nF (103) | h8 ↔ h11 |
| 점퍼선 (555 1번 → GND) | j10 ↔ 아래 − 레일 10열 |
| 저항 10kΩ | i11 ↔ 아래 + 레일 11열 |
| 점퍼선 (555 4번 → 5V) | j13 ↔ 아래 + 레일 14열 |
| 저항 330Ω | g12 ↔ g16 |
| 점퍼선 (330Ω → PhotoMOS 1번) | h16 ↔ h20 |
| AQY (홈이 왼쪽) | 1번=f20, 2번=f21 / 4번=e20, 3번=e21 |
| 트랜지스터 Q1 2N3904 | C=f23, B=f24, E=f25 (평평한 면이 가운데 홈 쪽) |
| 점퍼선 (Q1 컬렉터 → PhotoMOS 2번) | h23 ↔ h21 |
| 점퍼선 (Q1 이미터 → GND) | j25 ↔ 아래 − 레일 24열 |
| 저항 1kΩ | i24 ↔ i28 |
| 게이트 선 도착점 | g28 |
| 저항 10kΩ | j28 ↔ 아래 − 레일 28열 |
| AQY210EH LA: R1 바이패스 (홈이 왼쪽) | 1번=f17, 2번=f18 / 4번=e17, 3번=e18 |
| AQY210EH LB: R2 바이패스 (홈이 왼쪽) | 1번=f26, 2번=f27 / 4번=e26, 3번=e27 |
| 점퍼선 (LA 3번 → 게이팅 출력 20열) | c18 ↔ c20 |
| 저항 470Ω (R1, 사다리) | b17 ↔ b20 |
| 점퍼선 (17열 → 23열 (R1과 R2 사이)) | a17 ↔ a23 |
| 저항 1kΩ (R2, 사다리) | b23 ↔ b26 |
| 점퍼선 (LB 3번 → 23열) | c23 ↔ c27 |
| 사다리 선 도착점 (D11, R1 바이패스) | j14 |
| 저항 330Ω | i14 ↔ i17 |
| 점퍼선 (LA 2번 → GND) | j18 ↔ 아래 − 레일 18열 |
| 사다리 선 도착점 (D12, R2 바이패스) | j22 |
| 저항 330Ω | g22 ↔ g26 |
| 점퍼선 (LB 2번 → GND) | j27 ↔ 아래 − 레일 27열 |
| TENS 출력 (주황) | a21 ← TENS 리드 A(잘라서), a26 → 비상정지 NC → 참가자 STOP NC → 패드 A |

## CH2 (삼두근: 트리거 D7, 게이트 D6, 유지 D10)

| 부품 | 위치 |
|---|---|
| 유지 신호 선 도착점 | e33 |
| 커패시터 100nF (104) | c33 ↔ c35 |
| 저항 1kΩ | b35 ↔ b38 |
| 저항 10kΩ | a38 ↔ 위 − 레일 39열 |
| 트랜지스터 Q4 2N3904 | E=e37, B=e38, C=e39 (평평한 면이 가운데 홈 쪽) |
| 점퍼선 (Q4 이미터 → GND) | a37 ↔ 위 − 레일 36열 |
| 점퍼선 (Q4 컬렉터 → 555 7번) | d39 ↔ d41 |
| TLC555 (홈이 왼쪽) | 1번=f40, 2번=f41, 3번=f42, 4번=f43 / 8번=e40, 7번=e41, 6번=e42, 5번=e43 |
| 점퍼선 (555 8번 → 5V) | a40 ↔ 위 + 레일 40열 |
| 점퍼선 (555 7번 ↔ 6번) | b41 ↔ b42 |
| 저항 470kΩ | a41 ↔ 위 + 레일 41열 |
| 커패시터 100nF (104) | a42 ↔ 위 − 레일 42열 |
| 커패시터 10nF (103) | a43 ↔ 위 − 레일 44열 |
| 트리거 선 도착점 | j38 |
| 커패시터 10nF (103) | h38 ↔ h41 |
| 점퍼선 (555 1번 → GND) | j40 ↔ 아래 − 레일 40열 |
| 저항 10kΩ | i41 ↔ 아래 + 레일 41열 |
| 점퍼선 (555 4번 → 5V) | j43 ↔ 아래 + 레일 44열 |
| 저항 330Ω | g42 ↔ g46 |
| 점퍼선 (330Ω → PhotoMOS 1번) | h46 ↔ h50 |
| AQY (홈이 왼쪽) | 1번=f50, 2번=f51 / 4번=e50, 3번=e51 |
| 트랜지스터 Q2 2N3904 | C=f53, B=f54, E=f55 (평평한 면이 가운데 홈 쪽) |
| 점퍼선 (Q2 컬렉터 → PhotoMOS 2번) | h53 ↔ h51 |
| 점퍼선 (Q2 이미터 → GND) | j55 ↔ 아래 − 레일 54열 |
| 저항 1kΩ | i54 ↔ i58 |
| 게이트 선 도착점 | g58 |
| 저항 10kΩ | j58 ↔ 아래 − 레일 58열 |
| AQY210EH LA: R1 바이패스 (홈이 왼쪽) | 1번=f47, 2번=f48 / 4번=e47, 3번=e48 |
| AQY210EH LB: R2 바이패스 (홈이 왼쪽) | 1번=f56, 2번=f57 / 4번=e56, 3번=e57 |
| 점퍼선 (LA 3번 → 게이팅 출력 50열) | c48 ↔ c50 |
| 저항 470Ω (R1, 사다리) | b47 ↔ b50 |
| 점퍼선 (47열 → 53열 (R1과 R2 사이)) | a47 ↔ a53 |
| 저항 1kΩ (R2, 사다리) | b53 ↔ b56 |
| 점퍼선 (LB 3번 → 53열) | c53 ↔ c57 |
| 사다리 선 도착점 (A0, R1 바이패스) | j44 |
| 저항 330Ω | i44 ↔ i47 |
| 점퍼선 (LA 2번 → GND) | j48 ↔ 아래 − 레일 48열 |
| 사다리 선 도착점 (A1, R2 바이패스) | j52 |
| 저항 330Ω | g52 ↔ g56 |
| 점퍼선 (LB 2번 → GND) | j57 ↔ 아래 − 레일 57열 |
| TENS 출력 (주황) | a51 ← TENS 리드 A(잘라서), a56 → 비상정지 NC → 참가자 STOP NC → 패드 A |

## 조립 순서

1. 레일: 우노 5V·GND를 위 레일에, 59·60열에서 위아래 레일을 잇는다.
2. CH1의 TLC555와 AQY210EH를 가운데 홈에 걸쳐 꽂는다 (홈이 왼쪽).
3. 저항·커패시터 → 트랜지스터 → 보드 안 점퍼 순서.
4. 우노 신호선(D9, D4, D5)을 꽂고 GUIDE.md 4.3 LED 검사.
5. 통과하면 CH2를 30열 오른쪽에 똑같이 복제 (D10, D7, D6).
5-1. 강도 사다리 (v2.2): 채널마다 AQY 2개(LA·LB), 470Ω·1kΩ, 330Ω 2개, 점퍼. 우노 D11·D12(CH1), A0·A1(CH2). TENS 없이 `ladder_test.py`로 먼저 확인.
6. 마지막에 비상정지·참가자 STOP·TENS 출력(주황).
