kisan2970/ems-haptic-feedback/docs/breadboard_830.png

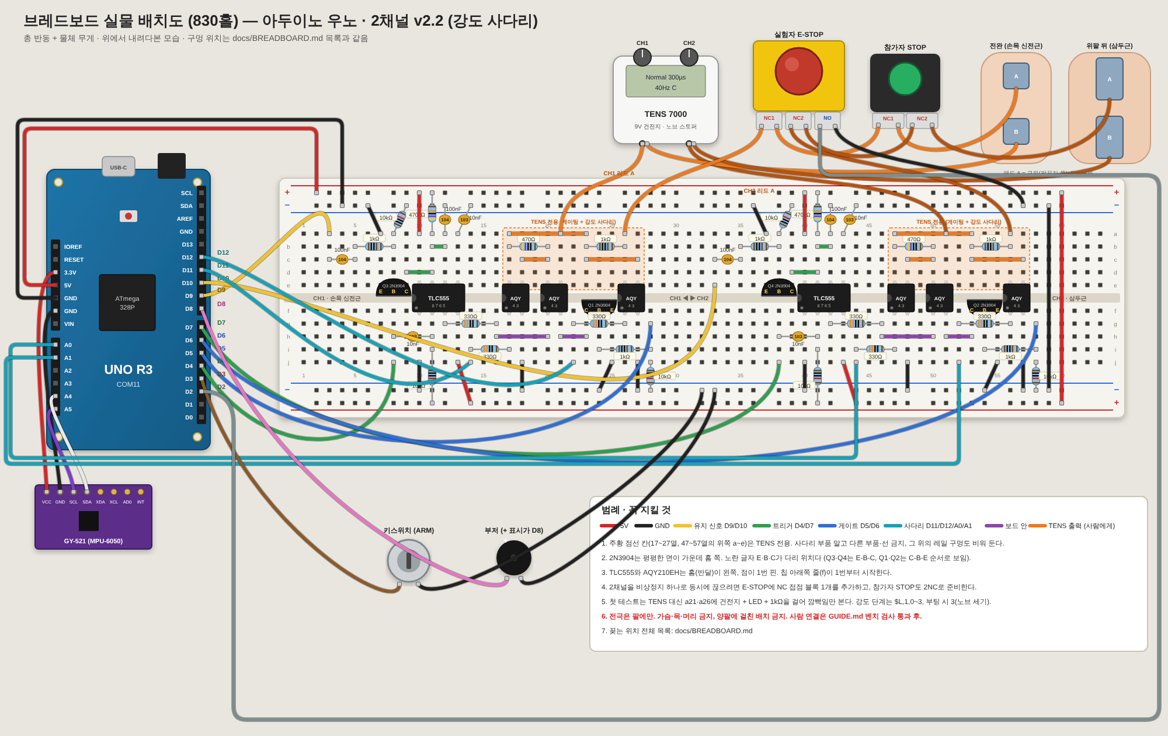
docs/breadboard_830.png
