kisan2970/ems-haptic-feedback/docs/breadboard_830_simple.png

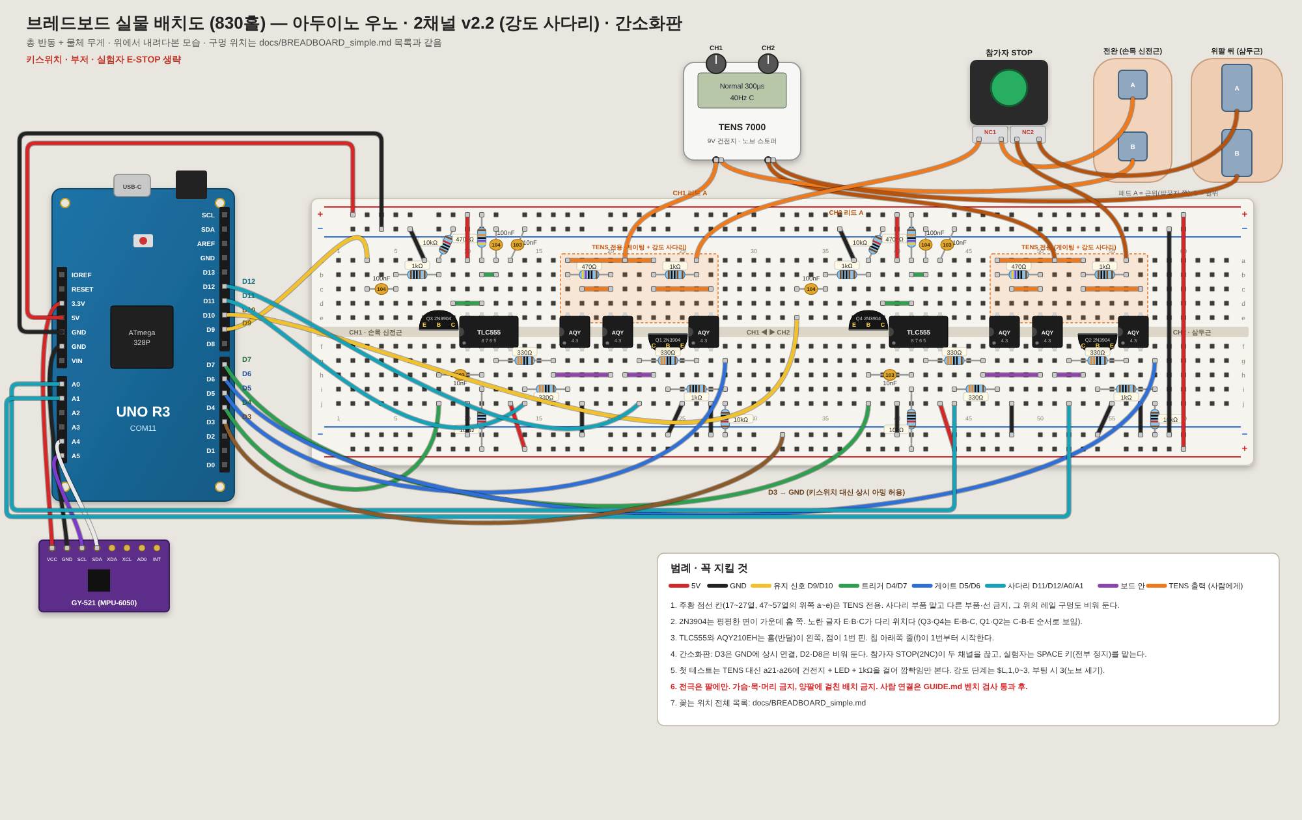
docs/breadboard_830_simple.png
