kisan2970/ems-haptic-feedback/docs/pad_placement.png

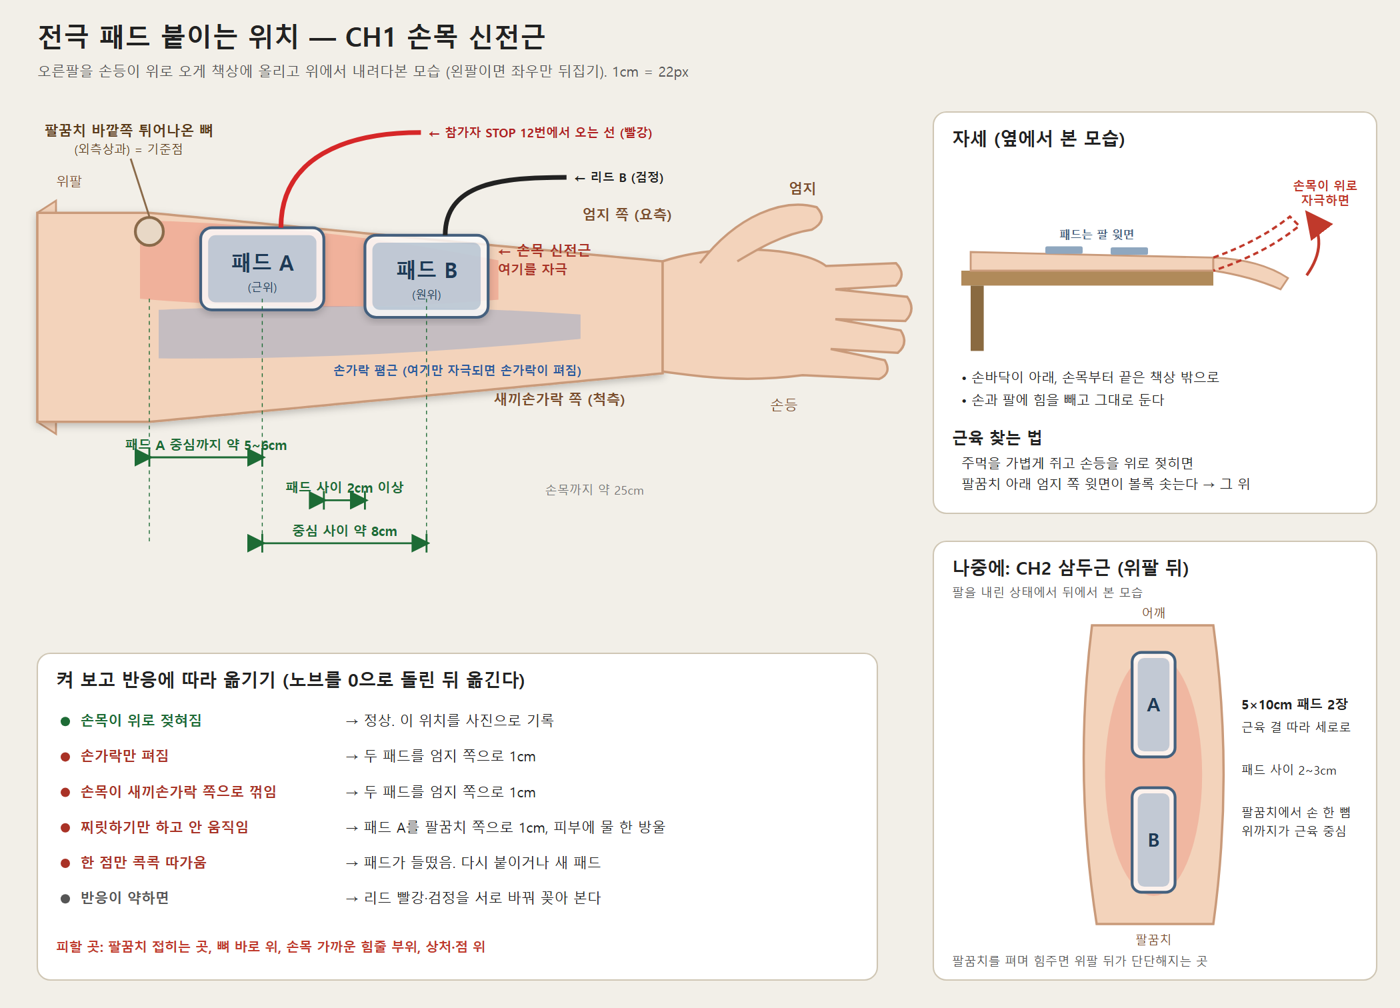
docs/pad_placement.png
