kisan2970/ems-haptic-feedback/docs/probe_a20_a21.png

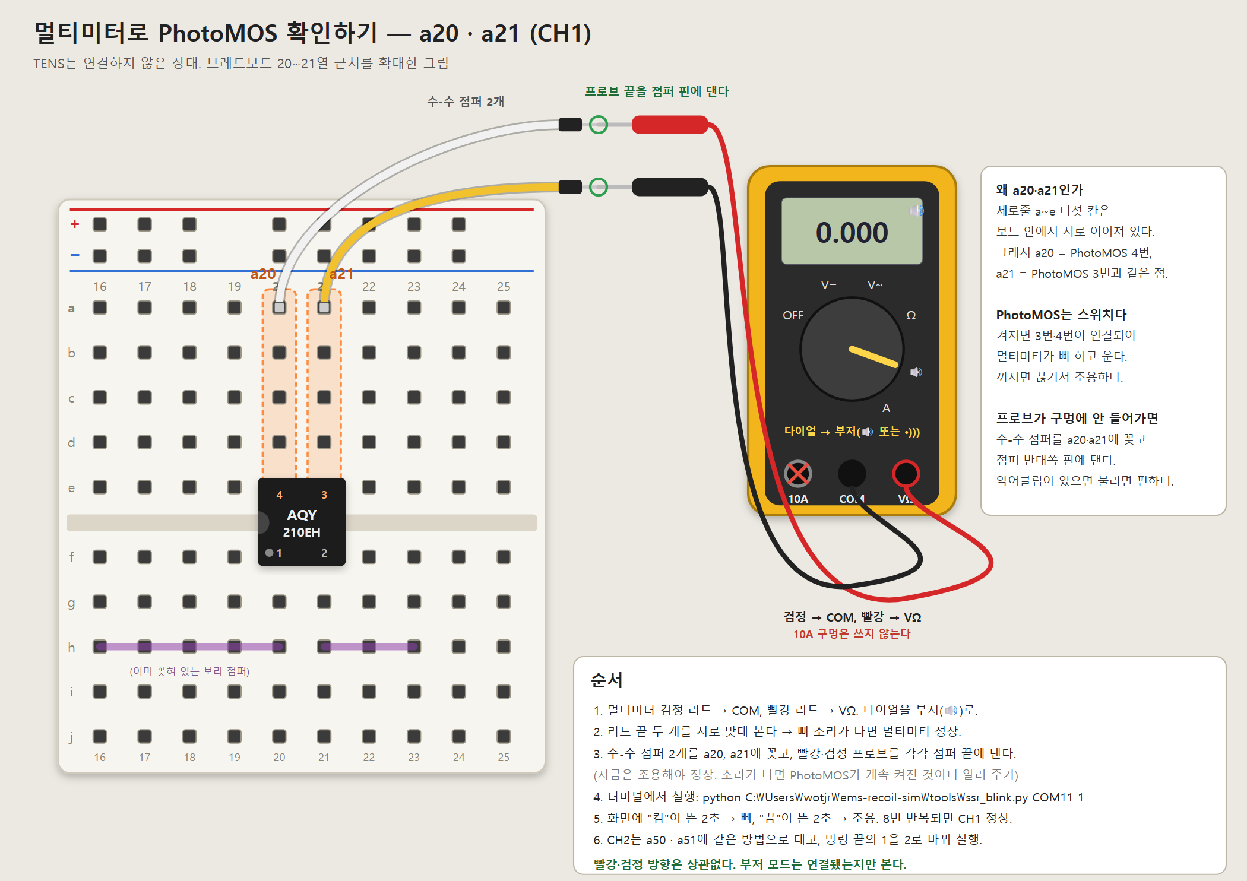
docs/probe_a20_a21.png
