kisan2970/ems-haptic-feedback/GUIDE.md

# EMS 근자극 기반 반동·무게감 피드백 — 완주 가이드 (v2)

처음부터 발표까지 순서대로 따라 하면 끝나는 절차서. 각 단계에 **통과 기준**이 있고, 통과하지 못하면 다음 단계로 넘어가지 않는다.
설계 근거는 [README.md](README.md), 논문은 [references.md](references.md), 배선도는 [docs/wiring_ch1_uno.png](docs/wiring_ch1_uno.png).

v2 변경점: 총 반동(짧게)과 물체 무게(길게) 두 가지를 시연한다. 555는 0.33초 고정 창 대신 **펄스 끊김 감지** 방식이고, 유지 신호 핀(D9, D10)과 방전 트랜지스터(Q3, Q4)가 추가됐다. MCU는 **아두이노 우노**(COM11).

---

## 0. 한 장 요약

| 항목 | 내용 |
|---|---|
| 시연 1 · 총 반동 | 방아쇠를 당기면 손목이 순간적으로 들린다. CH1 손목 신전근, 120ms 한 번 (`$T`) |
| 시연 2 · 물체 무게 | 물체를 드는 동안 팔이 아래로 끌린다. 보통 무게는 CH1, 무거운 무게는 CH1 + CH2 삼두근 (`$W`, 최대 5초) |
| 구성 | TENS 7000(9V, 아날로그 노브) → PhotoMOS 게이팅 → 전극 / IMU → 아두이노 우노 → Processing |
| 기기 설정 | Normal · Width 300µs · **40Hz** · 타이머 C (반동과 무게 공용) |
| 성공 기준 | (1) 저항 부하에서 명령한 시간만 출력 (2) 유지 신호가 끊기면 0.05초 안에 하드웨어 차단 (3) 비상정지 3종 동작 (4) 본인 팔에서 반동과 무게감이 구별됨 |

**절대 규칙**
1. 아두이노 회로를 거친 자극을 사람에게 연결하는 것은 5단계(벤치 검사) 전부 통과한 뒤에만.
2. TENS 쪽 선(주황)은 아두이노 GND·핀에 절대 닿지 않는다.
3. 전극은 팔에만. 가슴·목·머리 금지, 양팔에 걸친 배치 금지.

---

## 1. 진행 현황과 일정

| 단계 | 내용 | 상태 |
|---|---|---|
| 0 | 우노 펌웨어 업로드, 시리얼 응답 확인 | v1 완료 (9/28). **v2 재업로드 필요** |
| 1 | TENS 기기 단독 확인 | 완료 (9/29): Width 300µs, 9V 동작, 체감 확인 |
| 2 | 브레드보드 회로 조립 + LED 검사 | 브레드보드·점퍼선 대기 |
| 3 | 만능기판(또는 브레드보드 대안) 출력부 | 인두 대기 |
| 4 | 벤치 검사 (저항 부하, 안전장치 9종) | |
| 5 | 본인 캘리브레이션 (반동, 무게) | |
| 6 | 데모 장면 다듬기, 리허설, 발표 자료 | |

---

## 2. 준비물

### 2.1 보유 / 도착
TENS 7000 동형품, 아두이노 우노 호환(CH340), ESP32(VR 단계용), AQY210EH DIP-4 ×10, TLC555CP DIP-8 ×5, 저항 키트 600개(270k 없음), 커패시터 키트, 2N3904, 1N4148, 만능기판 7×9, KF301 단자대, 핀헤더, E-STOP(1NC+1NO), NC 버튼, 키스위치, 부저, GY-521, 하이드로겔 패드.

### 2.2 추가로 필요 (쿠팡)
| 품목 | 용도 |
|---|---|
| 브레드보드 830홀 + 점퍼선 세트(수-수, 암-수) | 저전압 회로 조립 |
| 온도조절 인두 세트 (60W) | GY-521 핀헤더, 출력부 납땜 |
| 디지털 멀티미터 (없다면) | 단락·절연·부하 측정 |
| 리드선 (기기 쪽 플러그 굵기 확인 후) | 한 가닥 잘라 SSR에 삽입. 동봉품은 자르지 않는다 |
| 9V 건전지 여분, 알코올 솜, 벨크로, 절연테이프 | |
| (선택) WAGO 221 레버 커넥터 | 납땜 없이 출력선 연결할 때 |

### 2.3 소프트웨어
- Arduino IDE 2.x (또는 arduino-cli). 보드 `Arduino Uno`, 포트 COM11. COM3~6은 블루투스 포트라 무시.
- Processing 4. 스케치의 `PORT_NAME`은 `"COM11"`로 되어 있다.

---

## 3. 1단계: 펌웨어 v2 업로드와 시리얼 검사 (회로 없이, 10분)

1. `firmware/ems_recoil/ems_recoil.ino`를 COM11에 업로드한다.
2. 자동 검사: `python tools/serial_test.py COM11`. 또는 시리얼 모니터(115200, 줄 끝 LF)에서 아래를 차례로 보낸다.

| 보낼 명령 | 기대 응답 | 의미 |
|---|---|---|
| (부팅) | `$I,EMS_RECOIL,v2,...` + `$S,...` 100Hz | v2 동작 |
| `$A,1*5C` | `$E,2,ARM_SWITCH_OFF` | D3가 GND 아님. 정상 |
| D3를 GND에 점퍼 후 `$A,1*5C` | `$K,A,1`, L LED 켜짐 | 아밍 |
| `$T,1,100,100,0*55` | `$K,T,1,100,100` | 반동 1회 |
| 바로 한 번 더 | `$E,14,TOO_SOON` | 반동 사이 300ms 간격 |
| `$W,1*4A` 를 0.1초 간격으로 계속 | 처음 한 번 `$K,W,1,1` | 무게 유지 시작 |
| 보내기를 멈춤 | 0.2초 뒤 `$K,W,1,0` | 재전송이 끊기면 해제 |
| `$W,1*4A` 를 6초 이상 계속 | 5초에 `$E,11,HOLD_LIMIT,1`, 이후 2초간 `$E,11,HOLD_REST,1` | 한 번 최대 5초 + 휴식 |
| 1초 이상 아무것도 안 보냄 | `$E,3,HEARTBEAT_LOST`, LED 꺼짐 | 하트비트 |
| D2를 GND에 잠깐 | `$E,1,FAULT`, 부저 | 비상정지 |
| D2 떼고 `$R*52` | `$K,R` | 해제 |

**통과 기준**: 표의 응답이 전부 일치한다.

---

## 4. 2단계: 브레드보드 회로 (저전압 측)

배선도 [docs/wiring_ch1_uno.png](docs/wiring_ch1_uno.png)의 왼쪽 파란 영역을 그대로 꽂는다. CH1 먼저, 검증 후 CH2 복제.

### 4.1 CH1 부품과 연결

| 블록 | 연결 |
|---|---|
| 전원 | 우노 5V → 브레드보드 + 레일, 우노 GND → − 레일. 그림의 모든 5V/GND 태그는 레일로 |
| TLC555 (U1) | 8번·4번 → 5V, 1번 → GND, 5번 → 10nF → GND |
| 타이밍 | 6번과 7번을 서로 연결 → 470kΩ(1MΩ도 가능, 그러면 0.11초) → 5V, 같은 점 → 100nF(104) → GND |
| 트리거 | D4 → 10nF → 555 2번. 2번 → 10kΩ → 5V |
| 유지 신호 (Q3) | D9 → 100nF → 1kΩ → Q3 베이스. 베이스 → 10kΩ → GND. Q3 컬렉터 → 555 6·7번, 이미터 → GND |
| 출력 | 555 3번 → 330Ω → PhotoMOS 1번(+) |
| 게이트 (Q1) | D5 → 1kΩ → Q1 베이스, D5 → 10kΩ → GND(풀다운 필수). Q1 컬렉터 → PhotoMOS 2번(−), 이미터 → GND |
| 패널 | D2 → E-STOP NO → GND, D3 → 키스위치 → GND, D8 → 부저(+) → GND |
| IMU | VCC → 5V, GND, SDA → A4, SCL → A5 |

2N3904는 글자가 쓰인 평평한 면을 보고 왼쪽부터 E-B-C.

**CH2**: 같은 회로를 한 벌 더. 트리거 D7, 게이트 D6, 유지 신호 D10.

### 4.2 동작 원리 (확인용)
- 555는 D4의 LOW 펄스로 켜진다. 켜진 뒤에는 6·7번의 100nF 커패시터가 470kΩ로 충전되며 약 0.05초 뒤 스스로 꺼지려 한다.
- 자극 중에는 D9가 5ms마다 토글되고, 상승 에지마다 Q3가 커패시터를 비운다. 그래서 자극하는 동안은 계속 켜져 있다.
- 아두이노가 멈추거나 D9가 HIGH/LOW로 고착되면 에지가 사라져 0.05초 안에 555가 꺼진다. 100nF 결합 때문에 HIGH 고착도 차단된다.
- SSR은 **555 출력 HIGH 그리고 D5 HIGH**일 때만 켜진다.

### 4.3 LED 검사 (TENS 없이)
PhotoMOS 3·4번 사이에 **별도 회로**(건전지 + LED + 1kΩ)를 건다. 우노 GND와 연결하지 않는다.

1. `$T,1,250,100,0*53` → LED 0.25초.
2. `$W,1*4A`를 0.1초 간격으로 3초 → LED 3초 켜짐, 멈추면 0.2초 안에 꺼짐.
3. **하드웨어 차단 검사**: `$W,1*4A`로 켠 상태에서 D9 점퍼를 뽑는다 → 0.05초 안에 LED 꺼짐. 다시 꽂아도 켜지지 않는다(트리거가 다시 와야 켜짐).
4. **HIGH 고착 검사**: D9를 우노 대신 5V 레일에 직접 꽂고 `$W,1*4A` → 0.05초 안에 꺼져야 한다.
5. **풀다운 검사**: 우노 리셋 버튼을 누르는 동안 LED 꺼짐.

**통과 기준**: 1~5 모두 통과.

---

## 5. 3단계: 출력부 (TENS 측)

배선도 오른쪽 주황 영역.

- v2.2부터: 리드 A(기기 쪽) → a21(게이팅 PhotoMOS 3번) → 강도 사다리(R1 470Ω, R2 1kΩ) → **a26** → (실험자 E-STOP NC) → 참가자 STOP NC → 전극 A. 그림: `docs/output_wiring_simple.png`.
- 예비 리드선의 한 가닥(A)을 잘라 기기 쪽을 a21에. 다른 가닥(B)은 그대로 전극 B로.
- 사다리 확인 (LED 부하, 사람 연결 금지): `python tools/ladder_test.py COM17 1` → 단계 3 → 2 → 1 → 0으로 LED가 점점 어두워지면 통과. 단계와 상관없이 밝기가 같으면 LA·LB 방향이나 D11·D12 선을 확인.
- 권장: 만능기판에 PhotoMOS와 KF301 단자대를 납땜. 브레드보드와는 1·2번 핀 점퍼선 두 가닥으로만 연결.
- 납땜이 어려우면: PhotoMOS를 브레드보드 가운데 홈에 걸쳐 꽂고(양쪽 7.6mm 간격), 출력선은 WAGO 커넥터로 잇고 테이프로 고정.
- 멀티미터로 **우노 쪽 어느 점과 TENS 쪽 어느 점 사이도 무한대**인지 확인.

---

## 6. 4단계: 벤치 검사 (사람 없이, 반나절)

### 6.1 부하 측정
1. 전극 자리에 저항 500Ω / 1kΩ / 2kΩ(1W).
2. 피크 검출기(1N4148 직렬 → 100nF 병렬 → 1MΩ 병렬 → 멀티미터 DC V) 또는 오실로스코프. 측정기를 우노에 연결하지 않는다.
3. 기기 Normal / 300µs / 40Hz / C. 노브 3, 6, 10에서 피크 전압 기록. 전류 = V/R.
4. `$W,1`로 켠 상태에서 같은 값이 나오는지 확인.
5. (오실로스코프가 있을 때) PhotoMOS는 TENS 펄스와 상관없이 열리고 닫혀서 펄스 중간을 자를 수 있다. 잘린 펄스는 양극성 균형이 깨져 피부에 직류 성분을 남긴다. 1kΩ 부하에서 `$T,1,120,100,0`과 `$T,1,120,50,0`(듀티 변조, 개폐가 많음)을 각각 10번 찍어 **켜진 직후 첫 펄스와 꺼지기 직전 마지막 펄스**를 본다. 반쪽 펄스가 자주 보이면 무게 모드에서는 듀티 100%만 쓴다.

| 노브 | 500Ω | 1kΩ | 2kΩ |
|---|---|---|---|
| 3 | | | |
| 6 | | | |
| 10 | | | |

**합격**: 1kΩ에서 노브 7 이하로 40mA 이상.

### 6.2 안전장치 검사 (영상으로 남긴다)

| 검사 | 방법 | 기대 결과 |
|---|---|---|
| 실험자 E-STOP | 자극 중 누름 | 즉시 출력 0, `$E,1,FAULT`, `$R` 전까지 명령 거부 |
| 참가자 STOP | 자극 중 누름 | 출력 0 (하드웨어만으로) |
| 키스위치 | ARMED 중 OFF | `$E,2`, 전부 정지 |
| 하트비트 | Processing 강제 종료 | 1초 내 정지, `$E,3` |
| 무게 재전송 끊김 | `$W` 전송 중단 | 0.2초 내 정지 |
| 무게 최대 시간 | `$W` 6초 이상 | 5초에 정지 + 2초 휴식 |
| 유지 신호 끊김 | 자극 중 D9 뽑기 | 0.05초 내 정지 (하드웨어) |
| USB 뽑기 | 자극 중 분리 | 즉시 정지 |
| 반동 예산 | 250ms 반동을 0.6초 간격으로 연속 | 13번째부터 `$E,5,BUDGET` |
| 무게 누적 예산 (v2.1) | 1초 들기·0.6초 쉬기를 1분 넘게 반복 | 누적 30초 근처에서 `$E,13,HOLD_BUDGET`, 이후 켜지지 않음 |
| 정지 후 재아밍 (v2.1) | 들기 중 `$X` → `$A,1` → 다시 들기를 반복 | 위와 같이 누적 30초에서 막힘 |

**통과 기준**: 11개 모두. 하나라도 실패하면 사람 연결 금지. 뒤의 두 줄은 펌웨어만의 동작이라 `tools/firmware_sim/`에서 PC로 먼저 확인할 수 있다.

---

## 7. 5단계: 본인 캘리브레이션 (보조자 1명 필수)

### 7.1 사전 조건
보조자가 E-STOP 옆. 심박조율기·뇌전증·심장질환·팔 상처 없음 확인. 노트북 배터리 구동. 노브 0. 새 패드.

### 7.2 CH1 손목 신전근 (반동 + 무게 공용)
1. 패드 A: 팔꿈치 바깥 뼈에서 손목 쪽 5cm, 전완 윗면. 패드 B: A에서 6cm 더 손목 쪽.
2. **강도 단계 3**(부팅 기본, 화면 오른쪽 위 "강도 3 / 3")인지 확인한다. 아밍 후 키 T(100ms)를 누르며 노브를 0.5씩 올려 S / M / C 기록. 사다리는 이보다 약하게만 만들 수 있다.
3. 운용 노브값 = M + 0.3 × (C − M). 커버 안쪽에 테이프 스토퍼.
4. 총 반동 확인: 손을 권총 쥔 자세로, `$T,1,120,100,0*57` → 손목이 들리면 통과.
5. 무게 확인: 손바닥을 위로, 팔꿈치 90도. `$W,1`을 3초 → 손이 아래로 끌리면 통과.
6. 강도 단계 확인: 들기 모드에서 `-` 키로 단계를 3 → 0까지 내리며 같은 자세로 끌림이 줄어드는지 기록한다. 단계 0에서도 감각이 남는지(S 이상인지) 본다.

### 7.3 CH2 삼두근 (무거운 무게)
1. 5×9cm 패드 2장을 위팔 뒷면 삼두근 위에 세로 8cm 간격.
2. `$W,2`로 켜며 노브를 올려 S / M / C 기록 (CH2 노브는 독립).
3. 팔꿈치 90도로 든 채 `$W,3*48`(두 채널)을 3초 → `$W,1`보다 확실히 무거우면 통과.
4. 3초 동안 힘이 빨리 빠지면 기기 Rate를 35Hz로 낮춘다.

### 7.4 기록지

| 항목 | CH1 손목 | CH2 삼두 |
|---|---|---|
| 날짜 / 대상 | | |
| Width / Rate | 300 / 40 | 300 / 40 |
| S / M / C (노브) | | |
| 운용값 | | |
| 반동 체감 (120ms) | | — |
| 무게 체감 (3초, 1~7) | | |
| 비고 | | |

---

## 8. 6단계: 시연 장면 (Processing)

`processing/EMSRecoilSim/EMSRecoilSim.pde`

| 키 | 동작 |
|---|---|
| 1 / 2 / 3 | 총 모드 / 들기 모드 / 벽 모드 |
| A | 아밍 |
| SPACE | 전부 정지 |
| R | FAULT 해제 |
| T | 테스트 반동 100ms |
| 클릭 또는 F | (총 모드) 발사 → 120ms 반동 |
| P | (들기 모드) 들기 / 내려놓기 |
| Z / X / C | (들기 모드) 가벼움 / 보통 / 무거움 |
| 4 | 공 무게 비교 모드 (블라인드 테스트) |
| 공 클릭 | (공 비교) 들기 / 내려놓기 |
| H | (공 비교) 어느 공이 무거운지 무작위로 섞기 |
| J / K | (공 비교) 참가자 답: 공1이 무겁다 / 공2가 무겁다. `ball_results_v2.csv`에 기록 후 자동으로 섞음 |
| L | (공 비교) 화면 지연 켜기/끄기. 기본은 켬 |
| V | (공 비교) 정답 보기 |

공 비교 모드: 두 공은 똑같이 생겼고 하나만 무겁다. 무거운 공을 드는 동안만 EMS가 켜지고, 화면 속 손도 느리게 따라온다. 지금은 CH1만 쓰며, CH2를 붙이면 스케치의 `HEAVY_MASK`를 1에서 3으로 바꾼다.

**블라인드 테스트 주의**: 참가자가 화면을 보면 손이 늦게 따라오는 공을 무거운 공으로 고를 수 있다. 그러면 정답률이 EMS 효과인지 화면 효과인지 알 수 없다. 발표용 결과는 두 조건으로 나눠 잰다. (1) L로 화면 지연을 끈 상태(EMS만), (2) 켠 상태(EMS + 화면). CSV의 `visual_lag` 열로 구분된다. 화면을 아예 참가자에게 보여주지 않는 방법도 된다.

펌웨어 v2.1부터 무게를 내려놓은 뒤 0.5초 안에는 다시 켜지지 않는다. 공을 바꿔 들 때 무거운 공의 자극이 0.5초 늦게 시작될 수 있으니, 공을 바꾸기 전에 한 박자 쉰다.

- 들기 모드에서 무거울수록 화면 속 손이 실제 팔보다 늦게 따라온다(시각 지연). EMS와 합쳐지면 무게 범위가 넓게 느껴진다.
- 가벼움 = 자극 없음, 보통 = CH1, 무거움 = CH1 + CH2.
- 5초가 지나면 펌웨어가 자동으로 내려놓게 하고 2초 쉰다. 시연 시나리오는 "들고 3초 유지 후 내려놓기"로 짠다.

### 8.1 참가자 절차 (5분)
1. 스크리닝 구두 확인 + 동의. STOP 버튼 눌러보기.
2. 패드 부착 → S/M/C → 운용값 (C 넘지 않게).
3. 총 발사 3회 → 들기 가벼움 / 보통 / 무거움 각 1회.
4. 패드 제거, 피부 확인, 소감.

### 8.2 리허설 체크리스트
- [ ] 9V 새 건전지 + 예비 2개
- [ ] 노트북 배터리 구동, 우노 COM11 확인
- [ ] 기기 Normal / 300µs / 40Hz / C, 노브 스토퍼
- [ ] 패드 20장, 알코올 솜, 테이프
- [ ] E-STOP 시연 포함 전체 흐름 2회
- [ ] 백업 영상 (본인 반동, 무게, 안전장치 검사)

---

## 9. 발표 자료 (12장)

| # | 슬라이드 | 내용 |
|---|---|---|
| 1 | 제목 | EMS 근자극 기반 가상 충돌 반동 및 무게감 피드백 시스템 |
| 2 | 문제 | 화면·VR 인터랙션에 힘 피드백이 없다. 외골격은 무겁고 비싸다 |
| 3 | 아이디어 | 사용자의 근육을 액추에이터로. Impacto(2015), Walls & Heavy Objects(2017) |
| 4 | 시스템 구조 | IMU → 우노 → Processing → 게이팅 → TENS → 근육 |
| 5 | 두 가지 자극 | 반동(짧은 한 번) vs 무게(지속 + 시각 지연), 근육 배정 |
| 6 | 왜 상용 TENS인가 | 출력단 무개조, 파라미터 표(300µs, 40Hz, 100mA) |
| 7 | 안전 아키텍처 | 5겹 + 유지 신호 하드웨어 차단 + 검사 영상 |
| 8 | 회로 | 배선도, 절연 경계 |
| 9 | 무게 표현 | 채널 쌓기 + 시각 지연 (CHI 2024 인용) |
| 10 | 캘리브레이션 | S/M/C 절차, 개인차 |
| 11 | 결과 | 체감 점수, 반동 각도, 참가자 소감 |
| 12 | 한계·향후 | 정전류 아님, 피로, 강도 단계 제한. openEMSstim, VR, 상체 웨어러블 |

---

## 10. 문제 해결

| 증상 | 원인 후보 | 조치 |
|---|---|---|
| 업로드 실패 "unable to open port" | 우노 미연결, 다른 프로그램이 포트 사용 | 케이블 확인, 시리얼 모니터·Processing 닫기 |
| `$E,6,BAD_CS` | 체크섬 오타, 줄 끝 설정 | 이 문서의 명령 복사, 줄 끝 LF |
| 아밍 안 됨 | D3가 GND 아님 | 키스위치 배선 |
| `$K,T`는 오는데 LED 안 켜짐 | 555 결선, Q1 방향, 트리거 결합 | 4.1 표 재확인, 555 3번 전압 측정 |
| 무게가 0.1초 만에 꺼짐 | Q3 결선 또는 D9 미연결 | D9 → 100nF → 1k → Q3 베이스 확인 |
| 무게가 5초 전에 꺼짐 | PC가 100ms마다 안 보냄 | Processing 창이 활성인지, 프레임 확인 |
| 근육 반응 없음 | 피부 임피던스, 위치, 강도 | 알코올 솜 + 물, 패드 1cm 이동 |
| 손가락만 펴짐 | 손가락 신전근 자극 | 패드를 엄지 쪽 1cm |
| 떨림·찌릿함이 큼 | 주파수 높음, 강도 M 미만 | 40Hz 이하, 강도 M 조금 위 |
| 무게가 금방 약해짐 | 근피로 | Rate 35Hz, 들기 3초로 짧게 |
| IMU 값이 튐 | TENS 노이즈 | IMU 선 짧게, 리드선과 떨어뜨리기 |

---

## 11. 부록

### 11.1 우노 핀 배치
| 핀 | 기능 |
|---|---|
| D2 | E-STOP NO → GND (인터럽트) |
| D3 | 키스위치 → GND |
| D4 / D7 | 555 트리거 CH1 / CH2 |
| D5 / D6 | 게이트 CH1 / CH2 (10k 풀다운) |
| D9 / D10 | 유지 신호 CH1 / CH2 (100nF 결합 → Q3/Q4) |
| D8 | 부저 |
| D13 | ARMED LED |
| A4 / A5 | IMU SDA / SCL |

### 11.2 명령 (체크섬 포함)
```
$H*48                 하트비트
$A,1*5C  / $A,0*5D    아밍 / 해제
$X*58                 전부 정지
$R*52                 FAULT 해제
$T,1,120,100,0*57     총 반동 (CH1 120ms)
$T,1,100,100,0*55     테스트 100ms
$T,1,250,100,0*53     반동 최대 250ms
$W,1*4A               무게 보통 (CH1)  - 100ms마다 재전송
$W,2*49               CH2만
$W,3*48               무게 무거움 (CH1 + CH2)
$W,0*4B               무게 해제
```

### 11.3 오류 코드
1 비상정지, 2 키스위치 OFF, 3 하트비트 끊김, 4 아밍 안 됨, 5 반동 예산 초과, 6 체크섬, 7 FAULT 중, 8 비상정지 눌린 채 해제 시도, 9 모르는 명령, 10 채널 오류, 11 무게 최대 시간/휴식, 12 채널 사용 중, 13 무게 1분 예산 초과, 14 반동 간격 너무 짧음.

### 11.4 스크리닝 문구
"이 체험은 상용 저주파 자극기로 팔 근육을 수축시킵니다. 심장박동기나 이식 전자기기, 뇌전증, 심장질환, 임신, 팔 피부 상처가 있으면 참여할 수 없습니다. 언제든 이 버튼을 누르면 즉시 멈춥니다. 참여하시겠습니까?"

### 11.5 다음 단계
- ESP32 펌웨어를 v2 구조로 갱신하고 WiFi UDP 추가 → Unity VR. (현재 `firmware/ems_recoil_esp32`는 v1 구조)
- openEMSstim 계열 감쇠단으로 무게 강도 단계 세분화.
- DPDT 릴레이 다중화로 한 팔 4근육 (README 5.6).
