kisan2970/ems-haptic-feedback/docs/output_wiring_simple.png

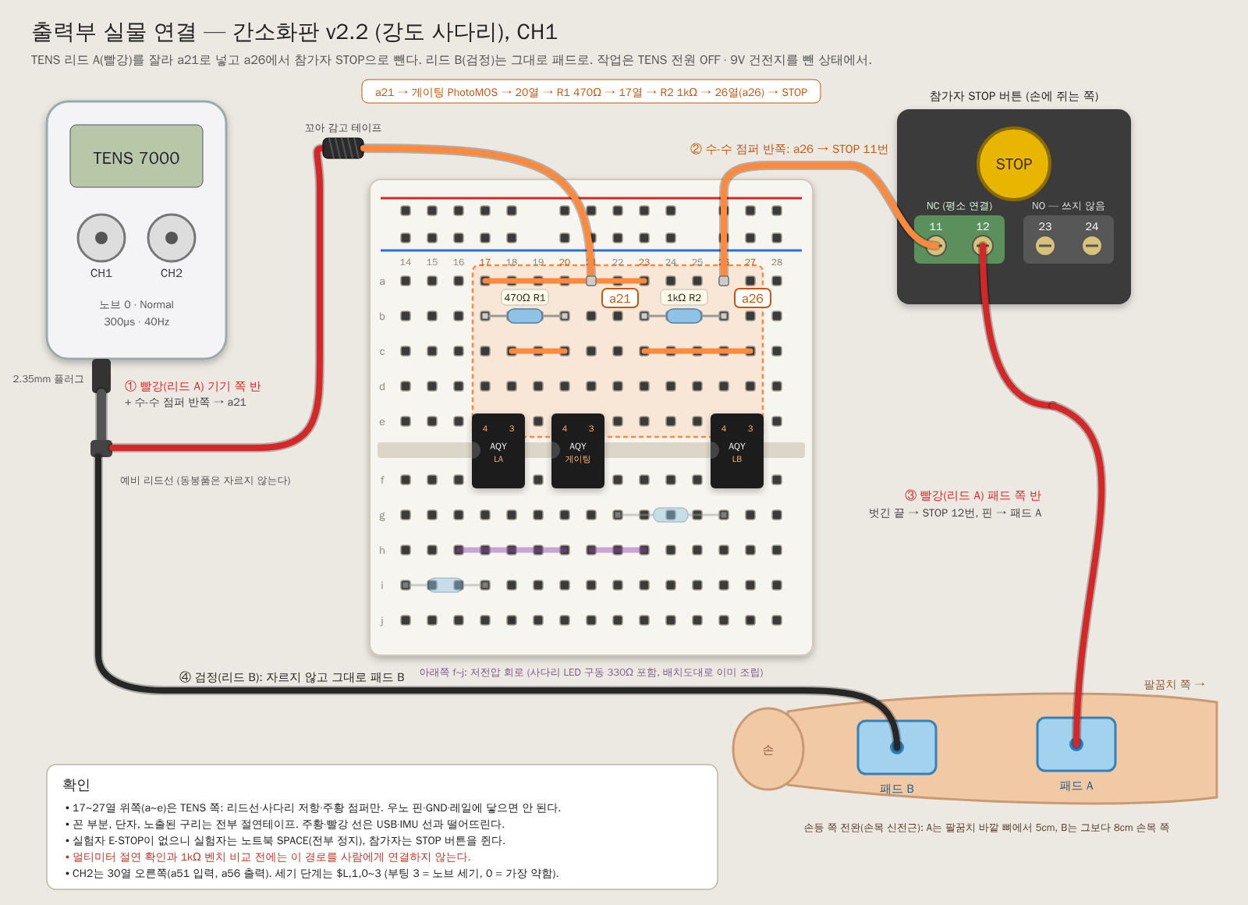
docs/output_wiring_simple.png
