kisan2970/ems-haptic-feedback/firmware/ems_recoil/ems_recoil.ino

/*
 * ems_recoil.ino  v2.2  -  EMS 근자극 기반 반동 + 무게감 피드백 펌웨어 (Arduino Uno)
 * Serial 115200
 *
 * 두 가지 자극
 *  - 반동(impulse): $T  한 번 60~250ms. 총 반동, 벽 충돌.
 *  - 무게(hold)   : $W  PC가 100ms마다 보내는 동안 계속. 한 번 최대 5초, 이후 2초 휴식.
 *
 * 핀 배치
 *  D2   E-STOP   비상정지 NO접점 -> GND (INPUT_PULLUP, LOW=눌림, INT0)
 *  D3   ARM      키스위치 -> GND (LOW=자극 허용)
 *  D4   TRIG1    TLC555 트리거 CH1 (평소 HIGH, 시작 시 100us LOW)
 *  D5   GATE1    Q1 베이스 CH1 (HIGH=자극)   ** 외부 10k 풀다운 필수 **
 *  D6   GATE2    Q2 베이스 CH2               ** 외부 10k 풀다운 필수 **
 *  D7   TRIG2    TLC555 트리거 CH2
 *  D8   BUZZ     부저
 *  D9   KA1      유지 신호 CH1 (자극 중 5ms마다 토글 -> 100nF 결합 -> Q3가 555 타이밍 C 방전)
 *  D10  KA2      유지 신호 CH2
 *  D11  LAD1A    CH1 강도 사다리: R1(470Ω) 바이패스 PhotoMOS (HIGH=바이패스)
 *  D12  LAD1B    CH1 강도 사다리: R2(1kΩ) 바이패스 PhotoMOS
 *  D13  LED      ARMED 표시
 *  A0   LAD2A    CH2 강도 사다리: R1 바이패스
 *  A1   LAD2B    CH2 강도 사다리: R2 바이패스
 *  A4/A5 I2C     MPU-6050
 *
 * 하드웨어 안전: 555는 "펄스 끊김 감지" 모드 (470k x 100nF = 약 0.05s).
 *   아두이노가 유지 신호를 토글하는 동안만 555 출력 HIGH. 루프가 멈추거나 핀이 고착되면 0.05초 안에 차단.
 *
 * 프로토콜  $BODY*HH\n  (HH = BODY XOR)
 *  PC -> MCU : $H  하트비트 / $A,1  $A,0  아밍 / $X  전부 정지 / $R  FAULT 해제
 *              $T,<ch>,<dur_ms>,<duty%>,<env>   반동 1회 (ch 1|2)
 *              $W,<mask>                         무게 유지 (mask 0=해제, 1=CH1, 2=CH2, 3=둘 다). 200ms 안에 재전송해야 유지
 *              $L,<ch>,<level>                   강도 단계 0~3 (3=노브 그대로, 0=가장 약함). 부팅 시 3
 *  MCU -> PC : $S,seq,roll,pitch,gx,gy,gz,ax,ay,az,dist,state   100Hz  (state 0 IDLE,1 ARMED,2 자극중,9 FAULT)
 *              $K,...  ACK  /  $E,<code>,<msg>  오류  /  $I,...  부팅
 *
 * v2.1 (10/28) 안전 예산 수정
 *  - 분당 반동 제한이 기록 버퍼(32)보다 커서(40) 동작하지 않던 문제: 버퍼를 제한 + 8로.
 *  - 무게 누적이 최근 8회만 세서 짧게 여러 번 들면 1분 30초 한도를 넘던 문제: 10초 칸별 시간 누적으로.
 *  - $X·하트비트·ARM·비상정지로 끊긴 무게가 누적에 안 들어가던 문제: allOff()가 holdStop()을 거친다.
 *  - 내려놓은 뒤 0.5초 안에는 다시 들기 불가.
 *  - I2C 타임아웃 3ms, 읽기 실패 시 그 샘플만 건너뜀.
 *
 * v2.2 (11/9) 강도 사다리
 *  출력 경로에 R1 470Ω, R2 1kΩ을 직렬로 넣고 각각을 PhotoMOS로 건너뛴다.
 *    단계 3 = 둘 다 바이패스(노브 세기 그대로) / 2 = R1만 / 1 = R2만 / 0 = 둘 다 들어감(가장 약함)
 *  리셋·전원 없음이면 바이패스가 열려 단계 0이 된다. 사다리는 노브로 정한 세기보다 세게 만들 수 없다.
 */
#include <Wire.h>
#include <avr/wdt.h>

#define PIN_ESTOP 2
#define PIN_ARM   3
#define PIN_BUZZ  8
#define PIN_LED   13

// ---------- 안전 한계 ----------
const uint16_t MAX_PULSE_MS       = 250;    // 반동 1회 최대
const uint16_t MIN_GAP_MS         = 300;    // 반동 사이 최소 간격 (채널별)
const uint32_t PULSE_WINDOW_MS    = 10000;
const uint16_t MAX_PULSE_ON_WIN   = 3000;   // 10초 중 반동 누적 3초
const uint8_t  MAX_TRIG_PER_MIN   = 40;
const uint16_t HOLD_REFRESH_TO_MS = 200;    // $W 재전송 없으면 해제
const uint16_t MAX_HOLD_MS        = 5000;   // 한 번 들기 최대
const uint16_t HOLD_REST_MS       = 2000;   // 최대 도달 후 강제 휴식
const uint16_t HOLD_MIN_GAP_MS    = 500;    // 내려놓은 뒤 다시 들기까지 최소 간격
const uint16_t HOLD_SLOT_MS       = 10000;  // 무게 누적은 10초 칸 6개(최근 약 1분)에 시간으로 쌓는다
const uint8_t  HOLD_SLOTS         = 6;      //  -> 들기 횟수와 상관없이 누적 시간이 정확하다
const uint32_t MAX_HOLD_IN_WIN    = 30000;  // 1분 중 채널당 누적 30초
const uint16_t HEARTBEAT_TO_MS    = 1000;
const uint8_t  MOD_PERIOD_MS      = 50;     // duty<100 일 때 켜고 끄는 주기 (떨림 질감)
const uint8_t  KA_HALF_MS         = 5;      // 유지 신호 토글 간격 (상승 에지 10ms마다)
const uint8_t  SENSOR_HZ          = 100;

enum Sys : uint8_t { SYS_IDLE = 0, SYS_ARMED = 1, SYS_FAULT = 9 };
enum Mode : uint8_t { M_OFF = 0, M_PULSE = 1, M_HOLD = 2, M_REST = 3 };

struct Chan {
  uint8_t gate, trig, ka, ladA, ladB;
  uint8_t level;
  uint8_t mode;
  uint32_t t0, lastRefresh, lastEnd, restUntil, lastKa, lastErr;
  uint16_t dur; uint8_t duty, env;
  bool kaLevel;
  uint16_t holdSlot[HOLD_SLOTS]; uint32_t holdSlotIdx;       // 무게 누적 (10초 칸별 ms)
};
Chan ch[2] = {
  {5, 4, 9, 11, 12},
  {6, 7, 10, A0, A1},
};

volatile uint8_t sys = SYS_IDLE;
volatile bool estopFlag = false;
uint32_t lastHeartbeat = 0;

const uint8_t LOG_N = MAX_TRIG_PER_MIN + 8;    // 반동 기록 (두 채널 합산). 분당 제한보다 커야 제한이 동작한다
uint32_t logT[LOG_N]; uint16_t logD[LOG_N]; uint8_t logI = 0;

float roll = 0, pitch = 0;
uint32_t lastSensor = 0; uint16_t seq = 0;
char rx[64]; uint8_t rxLen = 0;

// ---------- 유틸 ----------
void sendLine(const char* body) {
  uint8_t cs = 0; for (const char* p = body; *p; p++) cs ^= *p;
  Serial.print('$'); Serial.print(body); Serial.print('*');
  if (cs < 16) Serial.print('0'); Serial.println(cs, HEX);
}
void sendf(const char* fmt, int a1, int a2 = 0, int a3 = 0) {
  char b[40]; snprintf(b, sizeof b, fmt, a1, a2, a3); sendLine(b);
}

void chanOff(Chan& c) {
  digitalWrite(c.gate, LOW);
  digitalWrite(c.ka, LOW); c.kaLevel = false;
}
void holdStop(Chan& c, uint32_t now, bool rest);
// 어떤 경로로 끊겨도($X, 하트비트, ARM, 비상정지) 무게 사용 시간을 기록해야 예산을 우회할 수 없다
void allOff() {
  uint32_t now = millis();
  for (uint8_t i = 0; i < 2; i++) {
    Chan& c = ch[i];
    if (c.mode == M_HOLD) { holdStop(c, now, false); continue; }
    chanOff(c);
    if (c.mode == M_PULSE) { c.lastEnd = now; c.mode = M_OFF; }
  }
}
void estopISR() { digitalWrite(5, LOW); digitalWrite(6, LOW); estopFlag = true; }

// 강도 단계: R1(470Ω)은 ladA, R2(1kΩ)는 ladB가 바이패스한다
void setLevel(Chan& c, uint8_t lv) {
  c.level = lv;
  digitalWrite(c.ladA, (lv == 3 || lv == 1) ? HIGH : LOW);   // 3, 1: R1 바이패스
  digitalWrite(c.ladB, (lv == 3 || lv == 2) ? HIGH : LOW);   // 3, 2: R2 바이패스
}

void enterFault(uint8_t code) {
  allOff(); sys = SYS_FAULT;
  sendf("E,%d,FAULT", code);
  tone(PIN_BUZZ, 2000, 800);
}

bool anyActive() { return ch[0].mode == M_PULSE || ch[0].mode == M_HOLD || ch[1].mode == M_PULSE || ch[1].mode == M_HOLD; }

void chanStart(Chan& c) {
  digitalWrite(c.trig, LOW); delayMicroseconds(100); digitalWrite(c.trig, HIGH);  // 555 켜기
  c.kaLevel = true; digitalWrite(c.ka, HIGH); c.lastKa = millis();                // 첫 유지 에지
  digitalWrite(c.gate, HIGH);
}

// ---------- 예산 ----------
bool pulseBudgetOK(uint32_t now, uint16_t dur) {
  uint32_t on = 0; uint8_t cnt = 0;
  for (uint8_t i = 0; i < LOG_N; i++) {
    if (!logT[i]) continue;
    if (now - logT[i] < PULSE_WINDOW_MS) on += logD[i];
    if (now - logT[i] < 60000UL) cnt++;
  }
  return (on + dur <= MAX_PULSE_ON_WIN) && (cnt < MAX_TRIG_PER_MIN);
}
// 지금 칸으로 넘어가면서 지나간 칸을 비운다
void holdAdvance(Chan& c, uint32_t now) {
  uint32_t idx = now / HOLD_SLOT_MS;
  uint32_t d = idx - c.holdSlotIdx;
  if (!d) return;
  if (d >= HOLD_SLOTS) memset(c.holdSlot, 0, sizeof c.holdSlot);
  else for (uint32_t k = 1; k <= d; k++) c.holdSlot[(c.holdSlotIdx + k) % HOLD_SLOTS] = 0;
  c.holdSlotIdx = idx;
}
uint32_t holdUsed(Chan& c, uint32_t now) {
  holdAdvance(c, now);
  uint32_t s = 0;
  for (uint8_t i = 0; i < HOLD_SLOTS; i++) s += c.holdSlot[i];
  return s;
}
void holdStop(Chan& c, uint32_t now, bool rest) {
  chanOff(c);
  uint32_t len = now - c.t0;
  holdAdvance(c, now);
  uint16_t& slot = c.holdSlot[c.holdSlotIdx % HOLD_SLOTS];
  slot = (slot + len > 65000UL) ? 65000 : slot + len;
  c.lastEnd = now;
  if (rest) { c.mode = M_REST; c.restUntil = now + HOLD_REST_MS; }
  else c.mode = M_OFF;
}

// ---------- 명령 ----------
void cmdPulse(int n, int dur, int duty, int env) {
  uint32_t now = millis();
  if (sys != SYS_ARMED) { sendLine("E,4,NOT_ARMED"); return; }
  if (n != 1 && n != 2) { sendLine("E,10,BAD_CH"); return; }
  Chan& c = ch[n - 1];
  if (c.mode != M_OFF) { sendLine("E,12,BUSY"); return; }
  if (now - c.lastEnd < MIN_GAP_MS) { sendLine("E,14,TOO_SOON"); return; }
  dur = constrain(dur, 10, MAX_PULSE_MS); duty = constrain(duty, 10, 100);
  if (!pulseBudgetOK(now, dur)) { sendLine("E,5,BUDGET"); return; }
  logT[logI] = now ? now : 1; logD[logI] = dur; logI = (logI + 1) % LOG_N;
  c.dur = dur; c.duty = duty; c.env = env; c.t0 = now; c.mode = M_PULSE;
  chanStart(c);
  sendf("K,T,%d,%d,%d", n, dur, duty);
}

void cmdHold(int mask) {
  uint32_t now = millis();
  if (sys != SYS_ARMED) {
    if (mask) { static uint32_t le = 0; if (now - le > 500) { sendLine("E,4,NOT_ARMED"); le = now; } }
    return;
  }
  for (uint8_t i = 0; i < 2; i++) {
    Chan& c = ch[i];
    bool want = mask & (1 << i);
    if (want) {
      if (c.mode == M_HOLD) { c.lastRefresh = now; continue; }
      if (c.mode == M_PULSE) continue;                     // 반동 끝나면 다음 재전송에서 시작
      if (c.mode == M_REST) {
        if (now - c.lastErr > 500) { sendf("E,11,HOLD_REST,%d", i + 1); c.lastErr = now; }
        continue;
      }
      if (now - c.lastEnd < HOLD_MIN_GAP_MS) continue;     // 다음 재전송에서 다시 시도
      if (holdUsed(c, now) >= MAX_HOLD_IN_WIN) {
        if (now - c.lastErr > 500) { sendf("E,13,HOLD_BUDGET,%d", i + 1); c.lastErr = now; }
        continue;
      }
      c.t0 = now; c.lastRefresh = now; c.mode = M_HOLD;
      chanStart(c);
      sendf("K,W,%d,1", i + 1);
    } else if (c.mode == M_HOLD) {
      holdStop(c, now, false);
      sendf("K,W,%d,0", i + 1);
    }
  }
}

// ---------- 시리얼 ----------
bool checksumOK(char* line, char** body) {
  if (line[0] != '$') return false;
  char* star = strchr(line, '*'); if (!star) return false;
  uint8_t cs = 0; for (char* p = line + 1; p < star; p++) cs ^= *p;
  uint8_t given = strtoul(star + 1, NULL, 16);
  *star = 0; *body = line + 1;
  return cs == given;
}

void handleLine(char* line) {
  char* body;
  if (!checksumOK(line, &body)) { sendLine("E,6,BAD_CS"); return; }
  lastHeartbeat = millis();
  switch (body[0]) {
    case 'H': break;
    case 'X': allOff(); if (sys != SYS_FAULT) sys = SYS_IDLE; sendLine("K,X"); break;
    case 'A': {
      int v = atoi(body + 2);
      if (v == 1) {
        if (sys == SYS_FAULT)                  sendLine("E,7,IN_FAULT");
        else if (digitalRead(PIN_ARM) == HIGH) sendLine("E,2,ARM_SWITCH_OFF");
        else { sys = SYS_ARMED; sendLine("K,A,1"); }
      } else { allOff(); if (sys != SYS_FAULT) sys = SYS_IDLE; sendLine("K,A,0"); }
    } break;
    case 'T': {
      int n = 1, dur = 0, duty = 100, env = 0;
      sscanf(body, "T,%d,%d,%d,%d", &n, &dur, &duty, &env);
      cmdPulse(n, dur, duty, env);
    } break;
    case 'W': {
      int mask = 0; sscanf(body, "W,%d", &mask);
      cmdHold(mask & 3);
    } break;
    case 'R':
      if (sys == SYS_FAULT && digitalRead(PIN_ESTOP) == HIGH) { estopFlag = false; sys = SYS_IDLE; sendLine("K,R"); }
      else sendLine("E,8,ESTOP_STILL_PRESSED");
      break;
    case 'L': {
      int n = 0, lv = -1; sscanf(body, "L,%d,%d", &n, &lv);
      if (n != 1 && n != 2) { sendLine("E,10,BAD_CH"); break; }
      if (lv < 0 || lv > 3) { sendLine("E,15,BAD_LEVEL"); break; }
      setLevel(ch[n - 1], lv);
      sendf("K,L,%d,%d", n, lv);
    } break;
    default: sendLine("E,9,UNKNOWN");
  }
}

void readSerial() {
  while (Serial.available()) {
    char c = Serial.read();
    if (c == '$') { rxLen = 0; rx[rxLen++] = c; }
    else if (c == '\n' || c == '\r') { if (rxLen) { rx[rxLen] = 0; handleLine(rx); rxLen = 0; } }
    else if (rxLen && rxLen < sizeof(rx) - 1) rx[rxLen++] = c;
  }
}

// ---------- MPU-6050 ----------
void mpuWrite(uint8_t reg, uint8_t val) {
  Wire.beginTransmission(0x68); Wire.write(reg); Wire.write(val); Wire.endTransmission();
}
void mpuInit() {
  mpuWrite(0x6B, 0x00); mpuWrite(0x1C, 0x10); mpuWrite(0x1B, 0x10); mpuWrite(0x1A, 0x03);
}
void sensorTick() {
  static uint32_t tPrev = micros();
  static int16_t ax = 0, ay = 0, az = 4096, gx = 0, gy = 0, gz = 0;   // 읽기 실패 시 직전 값 유지
  Wire.beginTransmission(0x68); Wire.write(0x3B);
  // EMS 노이즈로 I2C가 잠기면 Wire 타임아웃(setup 참고)이 풀어 준다. 실패하면 이번 샘플만 건너뛴다
  if (Wire.endTransmission(false) == 0 && Wire.requestFrom(0x68, 14, true) == 14) {
    ax = Wire.read() << 8 | Wire.read(); ay = Wire.read() << 8 | Wire.read(); az = Wire.read() << 8 | Wire.read();
    Wire.read(); Wire.read();
    gx = Wire.read() << 8 | Wire.read(); gy = Wire.read() << 8 | Wire.read(); gz = Wire.read() << 8 | Wire.read();
  }
  uint32_t tNow = micros(); float dt = (tNow - tPrev) * 1e-6f; tPrev = tNow;
  float axg = ax / 4096.0f, ayg = ay / 4096.0f, azg = az / 4096.0f;
  float gxd = gx / 32.8f, gyd = gy / 32.8f, gzd = gz / 32.8f;
  roll  = 0.98f * (roll  + gxd * dt) + 0.02f * atan2(ayg, azg) * 57.2958f;
  pitch = 0.98f * (pitch + gyd * dt) + 0.02f * atan2(-axg, sqrt(ayg * ayg + azg * azg)) * 57.2958f;
  uint8_t st = (sys == SYS_FAULT) ? 9 : (anyActive() ? 2 : sys);
  char b[96], r[8], p[8];
  dtostrf(roll, 1, 1, r); dtostrf(pitch, 1, 1, p);
  snprintf(b, sizeof b, "S,%u,%s,%s,%d,%d,%d,%d,%d,%d,%d,%u",
           seq++, r, p, (int)gxd, (int)gyd, (int)gzd,
           (int)(axg * 100), (int)(ayg * 100), (int)(azg * 100), -1, st);
  sendLine(b);
}

// ---------- setup / loop ----------
void setup() {
  for (uint8_t i = 0; i < 2; i++) {
    pinMode(ch[i].gate, OUTPUT); digitalWrite(ch[i].gate, LOW);   // 가장 먼저 OFF
    pinMode(ch[i].ka, OUTPUT);   digitalWrite(ch[i].ka, LOW);
    pinMode(ch[i].trig, OUTPUT); digitalWrite(ch[i].trig, HIGH);
    pinMode(ch[i].ladA, OUTPUT); pinMode(ch[i].ladB, OUTPUT); setLevel(ch[i], 3);   // 기존 동작(노브 세기)과 같게 시작
  }
  pinMode(PIN_ESTOP, INPUT_PULLUP); pinMode(PIN_ARM, INPUT_PULLUP);
  pinMode(PIN_BUZZ, OUTPUT); pinMode(PIN_LED, OUTPUT);
  attachInterrupt(digitalPinToInterrupt(PIN_ESTOP), estopISR, FALLING);
  Serial.begin(115200);
  Wire.begin(); Wire.setClock(400000);
  Wire.setWireTimeout(3000, true);   // 3ms. 없으면 I2C가 잠길 때 루프가 멈춰 워치독 리셋이 반복된다 (AVR 코어 1.8.3 이상)
  mpuInit();
  wdt_enable(WDTO_250MS);
  sendLine("I,EMS_RECOIL,v2.2,PULSE<=250,HOLD<=5000,LADDER");
}

void loop() {
  wdt_reset();
  readSerial();
  // 명령 처리 뒤에 시각을 읽는다. 앞에서 읽으면 명령이 기록한 시각이 now보다 커져
  // (now - t) 부호 없는 뺄셈이 뒤집히고, 자극이 즉시 끝나거나 하트비트 끊김으로 오판한다.
  uint32_t now = millis();

  // --- 시스템 안전 감시 ---
  if ((estopFlag || digitalRead(PIN_ESTOP) == LOW) && sys != SYS_FAULT) enterFault(1);
  if (sys != SYS_FAULT && sys != SYS_IDLE && digitalRead(PIN_ARM) == HIGH) {
    allOff(); sys = SYS_IDLE; sendLine("E,2,ARM_SWITCH_OFF");
  }
  if (sys == SYS_ARMED && now - lastHeartbeat > HEARTBEAT_TO_MS) {
    allOff(); sys = SYS_IDLE; sendLine("E,3,HEARTBEAT_LOST");
  }

  // --- 채널별 상태 ---
  for (uint8_t i = 0; i < 2; i++) {
    Chan& c = ch[i];
    if (c.mode == M_PULSE) {
      uint32_t el = now - c.t0;
      if (el >= c.dur) { chanOff(c); c.lastEnd = now; c.mode = M_OFF; }
      else {
        uint8_t d = c.duty;
        if (c.env == 1) d = 100 - (uint32_t)(100 - c.duty) * el / c.dur;
        bool on = (d >= 100) || ((el % MOD_PERIOD_MS) < (uint32_t)MOD_PERIOD_MS * d / 100);
        digitalWrite(c.gate, on ? HIGH : LOW);
      }
    } else if (c.mode == M_HOLD) {
      if (now - c.lastRefresh > HOLD_REFRESH_TO_MS) { holdStop(c, now, false); sendf("K,W,%d,0", i + 1); }
      else if (now - c.t0 >= MAX_HOLD_MS) { holdStop(c, now, true); sendf("E,11,HOLD_LIMIT,%d", i + 1); }
      else if (holdUsed(c, now) + (now - c.t0) >= MAX_HOLD_IN_WIN) { holdStop(c, now, true); sendf("E,13,HOLD_BUDGET,%d", i + 1); }
    } else if (c.mode == M_REST && (int32_t)(now - c.restUntil) >= 0) {
      c.mode = M_OFF;
    }
    // 유지 신호: 자극 중에만 토글 (루프가 멈추면 555가 0.05초 안에 차단)
    if ((c.mode == M_PULSE || c.mode == M_HOLD) && now - c.lastKa >= KA_HALF_MS) {
      c.kaLevel = !c.kaLevel; digitalWrite(c.ka, c.kaLevel); c.lastKa = now;
    }
  }

  if (now - lastSensor >= 1000 / SENSOR_HZ) { lastSensor = now; sensorTick(); }
  digitalWrite(PIN_LED, sys == SYS_ARMED ? HIGH : LOW);
}
