kisan2970/ems-haptic-feedback/processing/EMSRecoilSim/EMSRecoilSim.pde

// EMSRecoilSim.pde  v2  -  Processing 4
// EMS 근자극 기반 반동 + 무게감 시연
//   [1] 총 모드  : 클릭 또는 F -> 반동 (CH1 손목 신전근 짧게)
//   [2] 들기 모드: P로 물체 들기/내려놓기, Z/X/C 무게 선택 -> 들고 있는 동안 계속 자극
//   [3] 벽 모드  : IMU로 손을 뻗어 벽에 부딪히면 반동
//   [4] 공 비교  : 똑같이 생긴 공 2개 중 하나만 무겁다 (블라인드 테스트)
//                  공 클릭 = 들기/내려놓기, H = 무거운 공 다시 섞기, J/K = 참가자 답(공1/공2가 무겁다), V = 정답 보기
//                  L = 화면 지연 켜기/끄기. 끄면 두 공이 똑같이 따라와 EMS만으로 맞히는지 본다 (CSV visual_lag 열)
// 공통: A 아밍, SPACE 전부 정지, R FAULT 해제, T 테스트 반동 100ms, - / = 강도 단계 내리기/올리기 (펌웨어 v2.2)
import processing.serial.*;

Serial port;
final String PORT_NAME = "COM11";        // 우노 포트. 바뀌면 콘솔의 목록 보고 수정

// ---- 반동 파라미터 ----
final int   RECOIL_MS   = 120;           // 총 반동 길이
final int   RECOIL_CH   = 1;             // 손목 신전근
// ---- 벽 매핑 ----
final float V_MAX = 3.0, GAMMA = 0.7, LEAD_S = 0.05, WALL_X = 0.72;
final int   T_MIN = 60, T_MAX = 220, REFRACT_MS = 300;
// ---- 들기 ----
// 무게 단계: {EMS 채널 마스크, 시각 추종 계수(작을수록 손이 늦게 따라옴 = 무겁게 보임)}
final String[] W_NAME = { "가벼움", "보통", "무거움" };
final int[]    W_MASK = { 0, 1, 3 };      // 0 = 자극 없음, 1 = CH1, 3 = CH1 + CH2(삼두근)
final float[]  W_FOLLOW = { 0.45, 0.18, 0.07 };
final float PITCH_MIN = -50, PITCH_MAX = 50;
// ---- 공 비교 ----
final int   HEAVY_MASK = 1;               // 지금은 CH1만. CH2(삼두근)를 붙이면 3으로 바꾸면 더 무거워짐
final float BALL_FOLLOW_LIGHT = 0.45, BALL_FOLLOW_HEAVY = 0.07;
final float[] BALL_X = { 330, 670 };

int mode = 1;                // 1 총, 2 들기, 3 벽, 4 공 비교
int ballHeld = -1, heavyIdx = 1, holdStart = 0;
boolean reveal = false;
boolean ballVisualLag = true;   // 참가자가 화면을 보면 지연만 보고도 무거운 공을 맞힐 수 있다. EMS만의 효과는 L로 끄고 잰다
int trials = 0, correct = 0;
float ballLiftY = 0;
int weight = 1;
int level = 3;               // 강도 사다리 단계 0~3. 펌웨어는 부팅 시 3(노브 세기 그대로)
boolean holding = false;
int lastHold = 0, lastHb = 0, lastTrig = 0;

float pitch, roll; int devState = 0;
float handX = 0.5, handV = 0, prevX = 0.5; int prevT = 0;
float liftY = 0;             // 들기 모드에서 화면 속 손 높이 (0~1)
boolean inside = false;
int flashUntil = 0; float kick = 0;
String lastMsg = "";

void setup() {
  size(1000, 600);
  frameRate(60);
  textFont(createFont("Malgun Gothic", 16));
  printArray(Serial.list());
  port = new Serial(this, PORT_NAME, 115200);
  port.bufferUntil('\n');
}

void draw() {
  int now = millis();
  if (now - lastHb > 200) { send("H"); lastHb = now; }
  // 들고 있는 동안 100ms마다 유지 신호
  if (mode == 2 && holding && now - lastHold > 100) {
    send("W," + W_MASK[weight]); lastHold = now;
  }
  if (mode == 4 && ballHeld >= 0 && now - lastHold > 100) {
    send("W," + (ballHeld == heavyIdx ? HEAVY_MASK : 0)); lastHold = now;
  }
  background(22);
  if (mode == 1) drawGun();
  else if (mode == 2) drawLift();
  else if (mode == 3) drawWall();
  else drawBalls();
  drawHud();
}

// ================= 총 모드 =================
void drawGun() {
  float aimY = map(constrain(pitch, PITCH_MIN, PITCH_MAX), PITCH_MIN, PITCH_MAX, height * 0.8, height * 0.2);
  kick *= 0.85;
  if (millis() < flashUntil) { background(90, 60, 20); }
  // 표적
  noFill(); stroke(200, 60, 60); strokeWeight(3);
  for (int r = 30; r <= 120; r += 30) ellipse(width * 0.7, height * 0.5, r * 2, r * 2);
  // 조준선
  stroke(80, 220, 120); strokeWeight(2);
  float cy = aimY - kick * 60;
  line(width * 0.7 - 20, cy, width * 0.7 + 20, cy); line(width * 0.7, cy - 20, width * 0.7, cy + 20);
  // 총
  pushMatrix(); translate(180, height * 0.62); rotate(-kick * 0.35);
  noStroke(); fill(170); rect(0, -18, 200, 30, 6); fill(120); rect(10, 10, 40, 70, 6);
  if (millis() < flashUntil) { fill(255, 220, 90); ellipse(215, -3, 50, 34); }
  popMatrix();
  fill(255); textSize(18); text("클릭 또는 F = 발사", 40, height - 60);
}
void fireGun() {
  if (millis() - lastTrig < 300) return;
  send("T," + RECOIL_CH + "," + RECOIL_MS + ",100,0");
  lastTrig = millis(); flashUntil = millis() + 80; kick = 1;
}

// ================= 들기 모드 =================
void drawLift() {
  // 실제 팔 각도 -> 목표 높이. 무거울수록 화면 속 손이 느리게 따라옴 (pseudo-haptics)
  float target = constrain(map(pitch, PITCH_MIN, PITCH_MAX, 0, 1), 0, 1);
  float follow = holding ? W_FOLLOW[weight] : 0.45;
  liftY = lerp(liftY, target, follow);
  float y = map(liftY, 0, 1, height * 0.8, height * 0.2);
  // 선반
  stroke(90); strokeWeight(4); line(560, height * 0.8 + 45, 900, height * 0.8 + 45);
  noStroke();
  // 손
  fill(240, 200, 170); ellipse(600, y + 30, 90, 36);
  // 물체
  float s = 40 + weight * 18;
  fill(holding ? color(90, 160, 240) : color(120));
  if (holding) rect(600 - s / 2, y - s + 12, s, s, 6);
  else rect(760 - s / 2, height * 0.8 + 45 - s, s, s, 6);
  fill(255); textSize(20);
  text("무게: " + W_NAME[weight] + (W_MASK[weight] == 0 ? " (자극 없음)" : W_MASK[weight] == 1 ? " (손목)" : " (손목 + 삼두근)"), 40, 110);
  textSize(18);
  text(holding ? "들고 있음 - P로 내려놓기" : "P = 들기   Z/X/C = 무게 선택", 40, height - 60);
}
void toggleHold() {
  holding = !holding;
  if (!holding) send("W,0");
  lastHold = 0;
}

// ================= 공 비교 모드 =================
void drawBalls() {
  float tableY = height * 0.78;
  stroke(110); strokeWeight(5); line(150, tableY + 32, 850, tableY + 32); noStroke();
  float target = constrain(map(pitch, PITCH_MIN, PITCH_MAX, 0, 1), 0, 1);
  float follow = (ballVisualLag && ballHeld == heavyIdx) ? BALL_FOLLOW_HEAVY : BALL_FOLLOW_LIGHT;
  ballLiftY = (ballHeld >= 0) ? lerp(ballLiftY, target, follow) : lerp(ballLiftY, 0, 0.3);
  for (int i = 0; i < 2; i++) {
    float bx = BALL_X[i];
    float by = (ballHeld == i) ? map(ballLiftY, 0, 1, tableY, height * 0.22) : tableY;
    if (ballHeld == i) { fill(240, 200, 170); ellipse(bx, by + 34, 110, 34); }
    fill(ballHeld == i ? color(230, 140, 60) : color(210, 120, 50));
    ellipse(bx, by, 64, 64);
    stroke(255, 255, 255, 120); strokeWeight(3); noFill(); arc(bx, by, 64, 64, -PI * 0.9, -PI * 0.3); noStroke();
    fill(255); textSize(20); textAlign(CENTER); text("공 " + (i + 1), bx, tableY + 70);
    if (reveal) { fill(i == heavyIdx ? color(255, 120, 100) : color(140, 220, 160)); text(i == heavyIdx ? "무거움" : "가벼움", bx, tableY + 96); }
    textAlign(LEFT);
  }
  if (ballHeld >= 0) {
    float left = max(0, 5.0 - (millis() - holdStart) / 1000.0);
    fill(80); rect(40, 120, 200, 12, 6); fill(left < 1.5 ? color(230, 90, 70) : color(120, 200, 140)); rect(40, 120, 200 * left / 5.0, 12, 6);
    fill(220); textSize(14); text("들고 있는 시간 (최대 5초)", 250, 131);
  }
  fill(255); textSize(16);
  text("공 클릭 = 들기/내려놓기   H = 섞기   J/K = 답(공1/공2가 무겁다)   V = 정답 보기   L = 화면 지연 " + (ballVisualLag ? "켬" : "끔"), 40, height - 60);
  text("시도 " + trials + "회   정답 " + correct + "회" + (trials > 0 ? "  (" + round(100.0 * correct / trials) + "%)" : ""), 40, 110);
}
void pickBall(int i) {
  if (ballHeld == i) { ballHeld = -1; send("W,0"); return; }
  if (ballHeld >= 0) send("W,0");
  ballHeld = i; holdStart = millis(); lastHold = 0;
}
void shuffleBalls() {
  if (ballHeld >= 0) { ballHeld = -1; send("W,0"); }
  heavyIdx = int(random(2)); reveal = false;
  lastMsg = "섞음 (정답은 V로 확인)";
}
void answer(int guess) {
  trials++; boolean ok = (guess == heavyIdx); if (ok) correct++;
  String row = year() + "-" + nf(month(), 2) + "-" + nf(day(), 2) + " " + nf(hour(), 2) + ":" + nf(minute(), 2) + ":" + nf(second(), 2)
             + "," + trials + "," + (heavyIdx + 1) + "," + (guess + 1) + "," + (ok ? 1 : 0) + "," + HEAVY_MASK + "," + (ballVisualLag ? 1 : 0);
  // visual_lag 열이 생기며 파일 이름을 바꿨다 (예전 ball_results.csv와 열 수가 달라 섞이지 않게)
  String[] old = loadStrings("ball_results_v2.csv");
  if (old == null) old = new String[] { "time,trial,heavy_ball,guess,correct,heavy_mask,visual_lag" };
  saveStrings("ball_results_v2.csv", append(old, row));
  lastMsg = "답 기록: 공" + (guess + 1) + (ok ? " 정답" : " 오답");
  shuffleBalls();
}

// ================= 벽 모드 =================
void drawWall() {
  float wx = WALL_X * width;
  noStroke(); fill(inside ? color(220, 60, 60) : color(90)); rect(wx, 0, width - wx, height);
  fill(80, 200, 255); ellipse(handX * width, height / 2, 44, 44);
  fill(255); textSize(18); text("IMU로 손을 뻗어 벽에 부딪히기", 40, height - 60);
}
void updateWall() {
  int t = millis(); float dt = (prevT == 0) ? 0.01 : (t - prevT) / 1000.0; prevT = t;
  float x = constrain(map(pitch, PITCH_MIN, PITCH_MAX, 0, 1), 0, 1);
  handX = lerp(handX, x, 0.5);
  handV = (handX - prevX) / max(dt, 1e-3); prevX = handX;
  float depth = handX - WALL_X;
  boolean predicted = (handV > 0.2) && (depth < 0) && ((-depth) / handV < LEAD_S);
  if (!inside && (depth >= 0 || predicted)) {
    inside = true;
    if (t - lastTrig > REFRACT_MS) {
      float vn = constrain(handV / V_MAX, 0, 1);
      int dur = round(T_MIN + (T_MAX - T_MIN) * pow(vn, GAMMA));
      send("T,1," + dur + ",100,0"); lastTrig = t;
    }
  } else if (inside && depth < -0.03) inside = false;
}

// ================= 공통 =================
void drawHud() {
  fill(255); textSize(22);
  String[] names = { "", "[1] 총 반동", "[2] 물체 무게", "[3] 벽 충돌", "[4] 공 무게 비교" };
  text(names[mode], 40, 50);
  textSize(14); fill(200);
  String st = devState == 9 ? "FAULT" : devState == 2 ? "자극 중" : devState == 1 ? "ARMED" : "IDLE";
  text("장치: " + st + "    pitch " + nf(pitch, 1, 1) + "    마지막 응답: " + lastMsg, 40, 76);
  text("A 아밍  SPACE 정지  R 해제  T 테스트  1/2/3/4 모드  -/= 강도 단계", 40, height - 25);
  textSize(18); fill(255, 200, 120); text("강도 " + level + " / 3", width - 170, 48);
  if (devState == 2) { fill(255, 80, 80); ellipse(width - 40, 40, 24, 24); }
}

void serialEvent(Serial p) {
  String line = p.readStringUntil('\n'); if (line == null) return;
  String body = verify(line.trim()); if (body == null) return;
  String[] f = split(body, ',');
  if (f[0].equals("S") && f.length >= 12) {
    roll = float(f[2]); pitch = float(f[3]); devState = int(f[11]);
    if (mode == 3) updateWall();
  } else {
    lastMsg = body;
    if (body.startsWith("E,11") || body.startsWith("E,13")) { holding = false; ballHeld = -1; }   // 최대 시간 도달 -> 자동 내려놓기
  }
}

void mousePressed() {
  if (mode == 1) fireGun();
  else if (mode == 4) {
    for (int i = 0; i < 2; i++) if (abs(mouseX - BALL_X[i]) < 90) pickBall(i);
  }
}

void keyPressed() {
  if (key == 'a' || key == 'A') send("A,1");
  else if (key == ' ') { holding = false; ballHeld = -1; send("X"); }
  else if (key == 'r' || key == 'R') send("R");
  else if (key == '-' || key == '=') {
    level = constrain(level + (key == '=' ? 1 : -1), 0, 3);
    send("L,1," + level); send("L,2," + level);
  }
  else if (key == 't' || key == 'T') send("T,1,100,100,0");
  else if (key == 'f' || key == 'F') { if (mode == 1) fireGun(); }
  else if (key == 'p' || key == 'P') { if (mode == 2) toggleHold(); }
  else if (key == 'z' || key == 'Z') weight = 0;
  else if (key == 'x' || key == 'X') weight = 1;
  else if (key == 'c' || key == 'C') weight = 2;
  else if (key == 'h' || key == 'H') { if (mode == 4) shuffleBalls(); }
  else if (key == 'v' || key == 'V') { if (mode == 4) reveal = !reveal; }
  else if (key == 'l' || key == 'L') { if (mode == 4) ballVisualLag = !ballVisualLag; }
  else if (key == 'j' || key == 'J') { if (mode == 4) answer(0); }
  else if (key == 'k' || key == 'K') { if (mode == 4) answer(1); }
  else if (key >= '1' && key <= '4') {
    if (holding || ballHeld >= 0) { holding = false; ballHeld = -1; send("W,0"); }
    mode = key - '0';
  }
}

void exit() { send("X"); super.exit(); }

// ---- $BODY*HH ----
synchronized void send(String body) { port.write("$" + body + "*" + hex(xor(body), 2) + "\n"); }
int xor(String s) { int c = 0; for (int i = 0; i < s.length(); i++) c ^= s.charAt(i); return c & 0xFF; }
String verify(String line) {
  int a = line.indexOf('$'), b = line.lastIndexOf('*');
  if (a < 0 || b < 0 || b < a || b + 3 > line.length()) return null;
  String body = line.substring(a + 1, b);
  return (xor(body) == unhex(line.substring(b + 1, b + 3))) ? body : null;
}
