kisan2970/ems-haptic-feedback/(commit log)

2026-09-29 EMS 근자극 기반 반동·무게감 피드백 프로토타입 초기 공개
    - 설계서, 완주 가이드, 브리핑, 관련 논문 목록
    - CH1 배선도 v2 (PhotoMOS 절연 게이팅, 555 유지 신호 감시)
    - Arduino Uno 펌웨어 v2: 반동($T)과 무게($W) 두 모드, 5겹 안전 구조
    - ESP32 펌웨어 (v1 구조, VR 단계용)
    - Processing 시연 화면: 총 / 들기 / 벽 모드
    - 시리얼 자동 검사, 배선도 생성 스크립트
2026-10-06 830홀 브레드보드 실물 배치도 추가, 타이밍 부품 변경
    - 브레드보드 실물 배치도와 구멍별 꽂는 위치 목록 (2채널)
    - 간소화판: 키스위치·부저·실험자 E-STOP 생략 버전
    - 555 타이밍을 470kΩ × 100nF(약 0.05초)로 변경 (1µF 미보유)
    - AQY210EH 출력 핀 번호를 3·4번으로 정정
    - 배치도 생성 스크립트 추가
2026-10-28 펌웨어 시간 계산 버그 수정, 공 무게 비교 모드, 점검 도구와 안내 그림 추가
    - 펌웨어: 명령 처리 뒤에 현재 시각을 읽도록 수정 (우노, ESP32)
    반동이 즉시 끝나거나 무게 유지가 풀리거나 하트비트 끊김으로 오판하던 문제
    - Processing: 똑같은 공 2개 중 하나만 무거운 블라인드 비교 모드, 결과 CSV 기록
    - 도구: 자동 점검(board_check), PhotoMOS 켜고 끄기 반복(ssr_blink)
    - 그림: 전극 패드 붙이는 위치, 멀티미터로 PhotoMOS 확인하는 법
    - 진행 요약 문서(SUMMARY.md), 가이드 키 안내 갱신
    [EMSRecoilSim.pde, board_check.py, ems_recoil.ino, ems_recoil_esp32.ino, make_pad_guide.py, make_probe_guide.py, ssr_blink.py]
2026-10-28 펌웨어 v2.1 안전 예산 수정, ESP32 v2 이식, 펌웨어 시뮬레이터 추가
    - 분당 반동 제한(40)이 기록 버퍼(32)보다 커서 동작하지 않던 문제 수정
    - 무게 누적을 10초 칸별 시간으로 계산 (짧게 반복해 들면 한도를 넘던 문제)
    - $X·하트비트·ARM·비상정지로 끊긴 무게도 누적에 기록
    - 재들기 최소 간격 0.5초, 우노 I2C 타임아웃 3ms
    - ESP32 펌웨어를 우노 v2.1 로직으로 이식 (유지 신호 GPIO32/33)
    - tools/firmware_sim: PC에서 안전 예산 9항목 시뮬레이션 (수정 전 5개 실패, 수정 후 9/9)
    - 공 비교 모드에 화면 지연 켜기/끄기(L), CSV visual_lag 열
    - README 프로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
    [EMSRecoilSim.pde, ems_recoil.ino, ems_recoil_esp32.ino, sim.cpp]
2026-11-09 INTRODUCTION.md 추가: 처음 보는 사람을 위한 프로젝트 소개
    문제, 아이디어, 시연 4종, 동작 구조와 안전 계층, 진행 상황,
    기여, 로드맵, 문서 안내. README 상단과 파일 목록에서 링크.
    Claude-Session: https://claude.ai/code/session_01MBewfkM6uKsHXpCMUrKh4P
2026-11-09 출력부 실물 연결 그림 추가 (간소화판, CH1)
    TENS 리드 A를 잘라 a21 → PhotoMOS → a20 → 참가자 STOP 11·12 → 패드 A,
    리드 B는 그대로 패드 B로 가는 연결을 그린 안내 그림과 생성 스크립트.
    BREADBOARD_simple 조립 순서와 README 파일 목록에서 링크.
    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
2026-11-09 듀티 변조 확인 스크립트 추가 (LED 부하용)
    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
2026-11-09 강도 사다리 추가 (펌웨어 v2.2): 470Ω·1kΩ 직렬 + PhotoMOS 바이패스 4단계
    - 출력 경로: a21 → 게이팅 PhotoMOS → R1 470Ω → R2 1kΩ → a26 → STOP.
    LA(17·18열)가 R1, LB(26·27열)가 R2를 건너뛴다. CH2는 30열 오른쪽.
    - 펌웨어 $L,<ch>,<0~3> (부팅 3 = 노브 세기, 0 = 가장 약함), 오류 15 BAD_LEVEL.
    우노 D11·D12·A0·A1, ESP32 GPIO23·4·13·14. 리셋되면 가장 약한 단계.
    - 시뮬레이터에 사다리 3항목 추가 (12/12, 우노·ESP32)
    - 배치도 두 장, 출력부 연결 그림, BREADBOARD 목록 갱신
    - Processing -/= 키로 강도 단계, tools/ladder_test.py (LED 부하 확인)
    - README 1.4b·프로토콜, GUIDE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
